Pytonballoon810/gdoor/hardware/boards/din/DESIGN.md

# GDoor DIN — design spec

A GDoor adapter for a 2-module DIN-rail enclosure (35 mm wide) with Ethernet,
audio and the bus interface on one board, the ESP32-S3 module soldered on.
Status: **layout routed and DRC-clean, schematic logic-checked (2026-10-18),
not yet built or tested.** The JLCPCB production files are in the repo (see
*Manufacturing*).

`esp32.kicad_sch` is the v4.1 bus and audio sheet (devkit removed);
`mcu_eth.kicad_sch` holds the new MCU, USB-C, power and Ethernet circuitry
(W5500 per WIZnet's WIZ850io reference). The file stem stays `esp32` because
the copied sheet stores its references under that project name.

Decisions (2026-10-16):

- Enclosure: 2 modules (35 mm), 3D printed. The PCB stands on edge, parallel
  to the side walls, so the connectors face the front window.
- MCU: ESP32-S3-WROOM-1-N8R2 module (8 MB flash, 2 MB quad PSRAM; PSRAM is
  needed for the VoIP audio stack), assembled by JLCPCB.
- Power: 5 V from USB-C or a screw terminal. No PoE, no power from the bus.
- Opening the door (bus TX) is mandatory and keeps its own pins; no feature
  may share them.

## Blocks

| Block | Based on | Notes |
|---|---|---|
| Bus interface (rectifier, RX filter and comparator, TX filter and driver, +5V_onoff switch) | v4.0 schematic | TX_EN switches the TX filter and driver supply (Q1/Q2), which keeps the TX stage off at boot. C10, R21 and C18 are DNP here but fitted on v4.0 (see *Open points*). |
| Bus voltage measurement | v4.0 (`BUS_DCVOLT`, R35/R73 100k/10k) | Divides by 11, so about 34 V reaches the ADC1 limit (v4.0 used 82k, ÷9.2). Closes issue #28 (bus connected/disconnected). |
| Audio codec ES8374 + bus coupling | v4.0 audio section | Own AMS1117 (U7, `+3.3V_ANA`). MONOOUT drives the bus through R32 and C21; the bus feeds MIC1P/MIC2P through C29/C31. Speaker outputs unused. |
| RX threshold | v4.0, fixed | The S3 has no DAC, so the fixed-threshold comparator U6A (`RX`, GPIO6) is used. The adjustable path (`RX_DAC`, R56) is removed; U6B is unused and sits latched high through R22/R27/R30/R31. |
| Ethernet | new: W5500 + HR911105A (magnetics and LEDs integrated) | 25 MHz crystal, WIZ850io reference circuit, PMODE all-capable. |
| MCU | new: ESP32-S3-WROOM-1-N8R2 | Native USB (flashing, console). SW101 = RESET (EN, 10k/1 µF), SW102 = BOOT (IO0, 10k). |
| USB-C | new: TYPE-C-31-M-12, 5.1 kΩ CC pull-downs, USBLC6-2SC6 ESD | Power and programming. |
| Power | AP2114H-3.3TRG1 (U103, LCSC C150716) for 3.3 V digital (S3 + W5500) | 5 V inputs OR-ed with SS14 Schottkys (D101 USB, D2 terminal). AP2114H: 1 A, 450 mV typ / 750 mV max dropout at 1 A, AMS1117 pinout (1 GND, 2/tab VOUT, 3 VIN). The AP2114**HA** has a different pinout and does not fit this footprint. 10 µF in (C104), 22 µF out (C106). |
| Status LEDs | new: two red 0603 LEDs, D103 (GPIO2, net `LED_GREEN_A`, 1 kΩ) and D104 (GPIO17, 1 kΩ) | D103 was green (C12624, Extended); JLC has no Basic green 0603, so it is the Basic red C2286 like D104, and R105 went from 100 Ω to 1 kΩ for the same ~1.3 mA. Issue #46. Plain LEDs instead of a WS2812, which needs more than 3.3 V logic when run from 5 V. |

## ESP32-S3 pin map

Avoided: GPIO0/3/45/46 (strapping; GPIO0 only for the BOOT button, GPIO3,
45 and 46 left open on their internal defaults), GPIO19/20 (USB), GPIO26–32
(flash/PSRAM), GPIO35–37 (kept free for octal-PSRAM module variants).

| Function | GPIO | Why there |
|---|---|---|
| Bus TX (LEDC PWM, 52 kHz) | 4 | mandatory, own pin |
| Bus TX enable | 5 | |
| Bus RX (comparator, digital) | 6 | |
| Bus RX analog | 7 | ADC1, usable with WiFi on |
| Bus DC voltage | 8 | ADC1 |
| Status LED D103 (red, net `LED_GREEN_A`) | 2 | |
| Status LED D104 (red) | 17 | |
| W5500 CS / MOSI / SCK / MISO | 10 / 11 / 12 / 13 | SPI2 IO_MUX pins, full speed |
| W5500 INT / RST | 14 / 21 | 4.7k pull-ups (also on CS) |
| I2S MCLK / BCLK / LRCK | 38 / 39 / 40 | S3 routes MCLK to any pin (the v4.0 GPIO0 problem is gone) |
| I2S DOUT (to codec DSDIN) / DIN (from codec ASDOUT) | 41 / 42 | |
| I2C SDA / SCL (codec control) | 47 / 48 | 2.4k pull-ups; codec address set by CE (R45 to GND) |
| Expansion header J103 (3V3, GND, TXD0, RXD0, IO15, IO16) | 43, 44, 15, 16 | serial console, sensors |

## Board and enclosure

- 4 layers, 1.6 mm, about 85 × 50 mm (height × depth in the housing), plus
  a 6.8 × 40.4 mm front tab (KiCad x 93.2–100, y 82.3–122.7). The tab sits
  in the 45 mm DIN front window, and its edge runs in a 0.3 mm groove in the
  window wall.
- Front: J102 (RJ45) and J101 (USB-C) stand on the tab, their faces 0.2 mm
  inside the window face (flush). The window has a body-sized RJ45 opening
  (16.6 × 13.9 mm), a stadium around the USB-C shell (9.4 × 3.7 mm) and two
  LED holes.
- Top edge: bus screw terminal J1 (2-pin, 3.5 mm) and 5 V screw terminal J4.
  Neither can take wires inside the enclosure (see *Open points*).
- RESET (SW101) and BOOT (SW102) are labelled on the silkscreen and on the
  lid, and pressed with a pin through the lid.
- The enclosure (printable base and lid, DIN clip) is in `enclosure/`; see
  its README. The bus connects through a pluggable 3.81 mm terminal on the
  top face, wired to J1's pads.
- Enclosure mirror fix (2026-10-22): up to then the enclosure was drawn
  around a mirror image of this board (`board_export.py` maps KiCad into the
  enclosure frame with a reflection), so the real board would not have
  fitted. `enclosure.scad` now mirrors every output about its mid-plane,
  which puts the lid on the other side; the real board fits, and the fit
  check is empty. See *Mirrored design frame* in the enclosure README.

## Layout

Stack-up and copper:

- The board's physical stackup is JLCPCB's JLC04161H-7628 (1.6 mm, 1 oz
  outer, 0.5 oz inner): 0.035 mm copper / 0.2104 mm 7628 prepreg (εr 4.4) /
  0.0152 mm / 1.065 mm core / 0.0152 mm / 0.2104 mm prepreg / 0.035 mm.
  Order the board with this stackup so KiCad's impedance numbers hold. A 2D
  field solve on it gives 65.7 Ω single-ended for a 0.2 mm track and
  98.8 Ω differential for the 0.2/0.15 mm USB and Ethernet RD pairs.
- F.Cu and B.Cu carry signals and a GND pour each (0.2 mm clearance, thermal
  reliefs, islands removed). In1.Cu is a GND plane, In2.Cu the +3.3V plane.
- GND stitching vias on a 3 mm grid tie the four layers together; each is
  placed only where it clears every other net.
- Antenna: the ESP32-S3-WROOM-1 footprint's own keepout covers F.Cu and
  B.Cu only. A rule area named "Antenna keepout (planes)" adds the same on
  In1.Cu and In2.Cu, so no plane runs under the antenna. The antenna sits at
  the board edge away from the RJ45.

Front-tab move (2026-10-17): J101 and J102 moved 8.45 mm forward (J102 also
0.8 mm down, to clear the top of the window), with their Ethernet parts
(R108, R117–R120, C121–C124) and USB parts (R103, D101, U102); R104 moved to
the old D101 corner. Tracks crossing the edge of the moved block kept their
geometry and got straight connectors along the move, so both halves of each
pair grew by the same amount: USB D+/D− skew is −4.20 mm (was −4.17), the
Ethernet pairs are unchanged. 17 stitching vias under the moved parts were
removed.

Rules (`esp32.kicad_pro`, `esp32.kicad_dru`, JLCPCB 4-layer):

- Vias 0.45 mm / 0.2 mm drill (JLCPCB standard, no extra cost on 4 layers);
  Default netclass track 0.2 mm; copper to edge 0.3 mm.
- The "PTH to Track" and "Pad to Track" rules apply to pads only; written
  for any item, they also caught vias and overrode the 0.254 mm via rule.
- Silkscreen text is 0.8 × 0.8 mm, 0.12 mm thick (the Nobble convention),
  placed clear of pads, other silk and the board edge. The "Minimum Text"
  rule was lowered from the JLC template's 1.0 / 0.15 to match. 39
  references in the densest 0402 groups (around the codec and the W5500)
  have no free spot and are hidden; they stay on F.Fab.

Parts removed from the copied v4.1 sheet:

- 2026-10-17: the microphone option parts C28, C30, R61–R66, R67 and R68,
  with their wiring; the codec speaker pins (U5 pins 11 and 14) are
  no-connects.
- 2026-10-18: the unfitted options R55 (+3.3V to `+3.3V_AUDIO` link), R56
  (`RX_DAC` link), R69–R72 (mic attenuation) and C62/C63 (alternative mic
  coupling), with their wiring and tracks.

Passives on the copied sheet are 0402 (C1, C12, C29, C31 stay 0603).

## Logic check (2026-10-18)

ERC has no errors; the 319 off-grid warnings come from the copied sheet.
Checked block
by block against the netlist:

- **Power:** both 5 V inputs are OR-ed by SS14 diodes (40 V). U103 and U7
  have their caps in place; the AP2114H has no enable pin.
- **USB:** CC1/CC2 have 5.1 kΩ pull-downs; ESD is on D+/D− and VBUS; D+/D−
  go to the module's USB pins.
- **ESP32-S3:** EN has 10k/1 µF and IO0 a 10k pull-up. IO3/45/46 are open,
  so the defaults hold: 3.3 V flash and normal boot.
- **W5500:** RSVD pins are tied to GND, PMODE pins high, EXRES 12.4k 1 %
  (R108 10k + R123 2.4k in series, see *Manufacturing*), TOCAP 4.7 µF,
  1V2O 10 nF. The 25 MHz crystal (C9006, CL 12 pF) has 15 pF caps and 1 MΩ
  across it (see *Simulation*). Analog supply goes through FB101. TX has 49.9 Ω to AVDD, RX is
  terminated 2 × 49.9 Ω to RX_CM (10 nF), and the shield goes through
  1 nF / 2 kV.
- **Bus:** RX is the v4.0 band-pass into U6A. TX is the band-pass U3 into
  the line driver U1, AC-coupled by C1 (47 nF 50 V).
- **Codec:** each supply has its own 33 Ω + 10 µF/100 nF. I2C has 100 Ω/22 pF
  in series and I2S 33 Ω/22 pF.

Found and fixed: the BOOT/RESET labels on the silkscreen (2026-10-17) and on
the enclosure lid were swapped. SW101 is wired to EN (RESET), SW102 to IO0
(BOOT).

## Simulation (2026-10-21)

`spice/` has an ngspice model of the bus side (bridge, RX and TX band-pass,
comparator, `+5V_onoff` switch, codec coupling). It runs on KiCad's bundled
`ngspice.dll`; numbers, assumptions and plots are in `spice/README.md`.

- **Fixed:** with R3/R4 = 100k the RX band-pass oscillated (see
  *Manufacturing*). They are back at 82k, as on v4.0.
- RX (82k) needs about 0.6 Vpp of 60 kHz carrier, or 0.4 Vpp at 52 kHz, on
  the bus terminals. TX puts 0.8–2.0 Vpp on them, depending on the bus
  impedance (assumed 30–300 Ω; not measured).
- Open risks, not confirmed on hardware: a driving codec MONOOUT shorts the
  RX signal through R32/C21. During TX, 16–31 mA of carrier flows into
  MONOOUT's ESD diodes. Plugging into a live bus pushes about 250 µC
  through MONOOUT into the codec supply, which U7 cannot sink (`+3.3V_ANA`
  rises to about 5 V in the model). The comparator rests only about 15 mV
  above its threshold.
- Ethernet (`spice/eth_sim.py`): return loss passes the 802.3 limit on both
  pairs with about 3.5 dB margin. The magjack is modelled from typical
  figures, so results above 30 MHz depend on that model. About 40 mA of TX
  current gives the nominal 1.0 V MLT-3 level. FB101 has no resonance
  problem. C121/C122 put the RX low corner at 220 kHz, as in WIZnet's
  reference.
- **Crystal load.** Y101 is C9006 (CL 12 pF, ±10 ppm, ±20 ppm over
  temperature, JLC Basic) since 2026-10-22, with C108/C109 at 15 pF (C1548,
  Basic). The model puts the pull at −5.5…+18.5 ppm for 3–5 pF stray, so the
  worst case with tolerance and temperature is about +48.5 ppm, inside
  802.3u's ±50 ppm. Before: C164045 (CL 20 pF, ±50 ppm over temperature,
  Extended); its 18 pF caps gave only 12–14 pF (+35…+55 ppm fast), and the
  33 pF fix of 2026-10-21 left no margin because of the ±50 ppm rating.

## Manufacturing

JLCPCB files live in `production/gdoor_din/` (gerbers, drill, BOM, CPL,
IPC netlist, iBOMs), generated by `jlcfab.py`:

```
"C:/Program Files/KiCad/10.0/bin/python.exe" jlcfab.py production/gdoor_din
```

It runs bennymeg's Fabrication Toolkit CLI (`-nI -nB -e -t -f`) on a copy of
the board in a temp directory and never writes the project files. `-f`
refills every zone before plotting.

- **Stale fill (fixed 2026-10-18):** the C10/R21 and C29/C31 changes were
  saved without a zone refill. Gerbers made from that fill had the GND pour
  over C10, R21 and C29 pads on F.Cu. The TX-node via at (129.0, 65.0) sat in
  GND and +3.3V. The GND vias at (128.3, 63.55) and (132.65, 64.3) sat in
  the In2 +3.3V plane. The board is now refilled and saved, and `-f` keeps a
  stale fill out of future exports.

On the copy, before the toolkit runs:

- **Rotation:** every part gets an `FT Rotation Offset`. `ROT_OVERRIDE`
  parts (Q1, Q2, U2, U3, D1, U102, J1) get a fixed final offset. Parts with
  the board's own `JlcRotOffset` / `JLCPCB Rotation Offset` (J4, U1, U5,
  U6, U7) keep exactly that offset. Every other part gets the toolkit's
  footprint-database correction. The overrides (2026-10-18) come from
  fitting JLC's EasyEDA footprint of each LCSC part onto the board's pads:
  `Library:SOT-23` and `Library:SOT-23-5` are drawn 180° from KiCad's
  standard footprints, so the database turned Q1/Q2/U2/U3 upside down;
  C2687116's EasyEDA SOT-23-6 is drawn turned 90°; J1's `JlcRotOffset`
  (-180) put its pads crosswise and is ignored.
- **Position:** U101 (ESP32 module, 3.63 mm: JLC's origin is the module
  centre), U7 (0.18 mm) and U103 (0.05 mm) get `FT Position Offset`s from
  the same fit.
- **J101 position:** J101 gets `FT Position Offset` `0,1.39`. KiCad's
  footprint origin sits 2.60 mm from the USB-C peg holes, JLC's model
  origin 1.206 mm. Aligned on the holes, JLC's point is 1.39 mm further
  +X on this board, where J101 sits at -90°. The CPL point is therefore
  97.09 / -108.0, not 95.70.
- **Hand-soldered parts left out:** `HAND_SOLDERED` parts are marked DNP,
  so they drop out of BOM and CPL like the DNP parts. This is the
  recommended, cheaper order; `hand_soldered.csv` lists those parts with
  C18 (quantities per board). A second pass keeps them in and writes
  `bom-full.csv` / `positions-full.csv` for a full PCBA order (Standard
  PCBA, C18 still by hand). J103 (expansion header) is a plain pin header
  (C37208). U101 (ESP32-S3-WROOM-1-N8R2, C2913204) cannot
  be placed in JLC's Economic PCBA. Its castellated pins take an iron; the
  centre GND pad (pad 41, split into sub-pads, one 0.3 mm via) needs hot air
  or a hot plate. The module is also grounded through pins 1 and 40. J1
  (C695629), J102 (C69427, HY911105AE), U103 (C150716), U102 (C2687116), U2/U3 (C7972)
  and C19/C20/C59 (C23742) are Extended parts that are easy to solder by
  iron; leaving them off saves JLC's $3 loading fee per part type. Order
  all of them from LCSC separately. Y101 stays with JLC: its pads are under
  the crystal.

After the toolkit:

- **BOM columns:** they are rewritten to JLC's template: `Comment,
  Designator, Footprint, LCSC Part #`. The toolkit's `Value`/`Quantity`
  columns made the PCBA quote fail ("fee item calculate failed").
- **BOM lines merged:** lines with the same LCSC part are merged, so a
  value spelled two ways ("4k7"/"4.7k") does not make JLC report two lines
  matched to one part.
- **Self-check:** the script checks that BOM and CPL list the same
  designators, that every BOM line has an LCSC number and no LCSC part is
  on two lines, and the CPL points and rotations of the corrected parts.
  It exits non-zero on a problem.

Extended-part fees (2026-10-18): none of these values is a JLC Basic 0402
part, so they were moved to fee-free parts:

- 18k (C25762), 2.4k (C25882) and 6.8 nF (C1542): same values,
  Preferred Extended parts (no loading fee in Economic PCBA).
- 82k → 100k Basic (C25741) for R18/R19 and R35. R18/R19 set the 2.5 V
  midpoint of the TX band-pass and are also its ground leg: with 100k its peak
  moves from 56 to 51 kHz, onto the 52 kHz TX carrier (+2.8 dB). R35
  changes the bus-voltage divider (see the table above).
- **R3/R4 stay 82k.** They were 100k from 7ce317d until 2026-10-21. They are
  the ground leg of the RX Sallen-Key band-pass (gain 1.94), and with 100k it
  oscillates on its own at about 49 kHz. It is stable below about 90k. See
  *Simulation*. JLC has no fee-free 82k in 0402, so they are 0603 since
  2026-10-22 (see below).
- R112/R113/R117/R118, 3.3 Ω → 0 Ω (C17168): series resistors between the
  W5500 TX/RX pins and the 49.9 Ω terminations, which sit on the magnetics
  side. The footprints stay, so 3.3 Ω can go back if EMI needs it.
- D103 green → red (C2286), R105 100 Ω → 1 kΩ (C11702).

Extended-part fees (2026-10-22): four more types made fee-free, values kept.
That saves $12 of the $24 that the eight charged types cost.

- R3/R4 82k: 0402 C2909388 → **0603 C23254** (Basic).
- R1/R20 130k: 0402 C2909318 → **0603 C22795** (Preferred Extended).
  The 0603 pads pushed two tracks: `Net-(J1-Pin_2)` between R3 and R5 now
  runs at y = 68.72 instead of 68.6, and the `Net-(C8-Pad2)` diagonal next to
  R20 moved 0.35 mm towards the `Net-(Q2-B)` track. The +3.3V via at R3 pad 2
  and the GND via at R4 pad 1 now sit partly under their (same-net) pads, as
  the C10-Pad2 via at R20 already did.
- R108 12.4k 1% (C2929935) → **R108 10k (C25744, Basic) + R123 2.4k
  (C25882, Preferred) in series**, 12.4k exactly; both 1 %. The node between
  them is `ETH_EXRES_LO`. R123 sits below R108; the GND via that was next to
  R108 pad 2 moved to R123 pad 2. R123's silkscreen reference is hidden (no
  free spot; it is on F.Fab). A single 12k would raise the TX amplitude by
  3.3 % of 802.3's ±5 %.
- Y101 C164045 → **C9006** (Basic), same 3225-4P footprint; C108/C109
  33 pF → **15 pF** (C1548) for its CL of 12 pF. See *Simulation*.
- Still Extended at JLC: U1 (no fee-free op amp has 20 V/µs and ±60 mA),
  U5, U104 and J101 (no fee-free USB-C exists).

The iBOMs: `ibom.html` comes from the InteractiveHtmlBom plugin (with tracks
and nets), `ibom-partdb.html` from `partdb_ibom.py` (Part-DB storage and JLC
cost; `--offline` reuses `jlc-prices.json`).

Other notes:

- **No popups:** KiCad's python pops a modal wx dialog for every assert and
  log message. The script disables both, and stubs
  `pcbnew.ActionPlugin.register`, before importing anything. Otherwise
  the toolkit asserts ("PgmOrNull()" failed in register_action).
- **LCSC numbers** come from the `LCSC` field, or from `MPN` on the copied
  sheet.
- **Single-sided assembly:** every B.Cu part is DNP. Left on B.Cu: C18
  (hand-soldered, see *Open points*) and the ESD logo S1.
- **Check rotations** in JLCPCB's placement preview anyway. D104 and J101
  look wrong to the pad fit and are right: JLC's LED numbers the cathode
  pad 2 (matched by cathode, 0° is correct), and J101 is aligned on its
  peg holes, not on its signal pads.

## Firmware impact

- MQTT firmware: needs an S3 build environment and a third pin map (in
  addition to v3.x and v4.0); Ethernet via the existing W5500 support with the
  new pins; the RX threshold via LEDC PWM instead of `dacWrite`.
- Audio: the working VoIP firmware (ESP-ADF) is the maintainer's private code;
  this board only provides the hardware for it.

## Open points

Decisions:

- **C10, R21, C18** (done 2026-10-18): fitted on the upstream
  `hardware/boards/esp32-mini` board, so they are fitted here too.
  - C18 (100 pF) filters the TX driver input (U1 +, with R11 10k).
  - C10 (1 nF) and R21 (4k7) load the TX node behind R34; R21 also pulls TX
    low while the pin floats.
  - C10 and R21 are on F.Cu and fitted by JLC, at (131.25, 64.3) and
    (128.9, 64.3). A via at (129.0, 65.0) joins them to the old B.Cu TX-node
    track, and GND vias at (128.3, 63.55) and (132.65, 64.3) ground them.
  - C18 stays on B.Cu, routed but DNP: **hand-solder it** (100 pF 0402,
    C1546). There is no free F.Cu spot near U1 or R11, because the strip
    above U1 is crossed by the C1-Pad1 and +5V_onoff diagonals and Q2 and
    R14/R15/R16/R24 close in on the other sides.
- **C29, C31** (done 2026-10-18): they sit on the bus DC through R74, so
  they now have a 50 V rating (the bus runs up to about 30 V).
  - C29: 10 µF 50 V 1206 (C13585, like C21), at (120.6, 106.3).
  - C31: 10 µF 50 V 0805 (C440198, Murata GRM21BR61H106KE43L), at (129.357,
    100.5); a 1206 did not fit there. Its pad-1 route to R40 now runs down
    the right side of the part at x 130.385.
- **0 Ω links:** R34, R36, R57, R58, R59, R60 and R74 are fitted 0 Ω links
  left over from upstream options. They could become plain copper (7 fewer
  placements), but each one would need a schematic and routing change.
- **J4 and D2:** the 5 V terminal cannot take wires in the enclosure (its
  entries face the top wall), so the second 5 V input is only usable with
  wires soldered to J4's pads. Keep it, or drop J4 and D2.
- **Unused parts:** U6B with its four resistors, and the codec's MICBIAS caps
  C22/C35, are unused on this board. They are kept so the unused inputs stay
  defined.
- **Status LEDs** (done 2026-10-18): both are red now, each with 1 kΩ
  (about 1.3 mA), so they are equally bright.

To do in KiCad:

- **Tidy:** the front-tab connectors are long straight runs across the
  strip the move emptied (x 113–122, y 98–113). That strip also has room for
  new stitching vias.

To check on the first build:

- U103 is a JLC extended part ($3 fee); check its rotation in the placement
  preview.
- Front window: the RJ45 opening, the USB-C stadium and the tab groove
  (1.1 mm of wall left) need checking on the first print.
- J1 should be DNP: the enclosure wires the bus plug straight to its pads,
  but it is in the JLC BOM as C695629.
- J103 (expansion header, C37208) is hand-soldered in the recommended order.
- Several decoupling caps sit further from their pins than ideal (C116,
  C57, C59, C61, C29 are 5–12 mm away), and some codec/W5500 routes meander.
