Pytonballoon810/gdoor/hardware/boards/din/production/gdoor_din/bom-full.csv

Comment | Designator | Footprint | LCSC Part #
47n | C1 | 0603 | C1622
1n | C10 | 0402 | C1523
10u | C101, C104, C105, C112, C116 | 0603 | C19702
100n | C22, C24, C26, C32, C33, C34, C102, C107, C114, C115, C117, C118, C119 | 0402 | C1525
1u | C103, C113 | 0402 | C52923
22u | C106 | 0805 | C45783
15p | C108, C109 | 0402 | C1548
100n | C3, C5, C6, C7, C11, C13, C15, C16, C17, C36, C38, C40, C42, C46, C51, C53, C55 | 0402 | C307331
4.7u | C110 | 0603 | C19666
10n | C111, C123 | 0402 | C15195
10u | C12 | 0603 | C96446
22n | C120 | 0402 | C1532
6.8n | C121, C122 | 0402 | C1542
1n 2kV | C124 | 1206 | C9196
10u | C14, C23, C25, C27, C35, C37, C39, C41, C43, C47, C52, C54, C56 | 0402 | C15525
100u | C19, C20, C59 | 1210 | C23742
100p | C2, C4, C8, C9 | 0402 | C1546
10u | C21, C29, C57 | 1206 | C13585
10u | C31 | 0805 | C440198
22p | C44, C45, C48, C49, C50, C61 | 0402 | C1555
MB10S | D1 | SOIC-4_4.55x3.7mm_P2.54mm | C2488
SS14 | D2, D101 | D_SMA | C2480
red | D103, D104 | 0603 | C2286
120R@100MHz | FB101 | 0603 | C14709
PlugIn_Terminal_Screw | J1, J4 | anschlussklemme2x1_3_5 | C695629
USB-C | J101 | USB_C_Receptacle_HRO_TYPE-C-31-M-12 | C165948
HY911105AE | J102 | RJ45_Hanrun_HR911105A_Horizontal | C69427
EXP | J103 | PinHeader_1x06_P2.54mm_Vertical | C37208
MMBT5401 | Q1 | SOT-23 | C8326
MMBT2222A | Q2 | SOT-23 | C8512
130k | R1, R20 | 0603 | C22795
18k | R6, R10, R15, R22, R27, R33 | 0402 | C25762
10k | R8, R11, R13, R23, R24, R29, R31, R45, R73, R101, R102, R108 | 0402 | C25744
5.1k | R5, R7, R16, R17, R103, R104 | 0402 | C25905
1k | R14, R37, R38, R39, R40, R105, R106 | 0402 | C11702
1M | R107 | 0402 | C26083
4.7k | R21, R26, R109, R110, R111 | 0402 | C25900
0 | R34, R36, R57, R58, R59, R60, R74, R112, R113, R117, R118 | 0402 | C17168
49.9 1% | R114, R115, R119, R120 | 0402 | C25120
10 | R116 | 0402 | C25077
2k4 | R12, R25, R46, R47, R123 | 0402 | C25882
330 | R121, R122 | 0402 | C25104
100k | R18, R19, R35 | 0402 | C25741
22k | R2 | 0402 | C25768
47k | R9, R28, R30 | 0402 | C25792
82k | R3, R4 | 0603 | C23254
22 | R32 | 0402 | C25092
33 | R41, R42, R43, R44, R50, R51, R52, R53, R54 | 0402 | C25105
100 | R48, R49 | 0402 | C25076
TL3342 | SW101, SW102 | SW_SPST_TL3342 | C318884
TLV9351 | U1 | SOT-353_SC-70-5 | C4367425
ESP32-S3-WROOM-1-N8R2 | U101 | ESP32-S3-WROOM-1 | C2913204
USBLC6-2SC6 | U102 | SOT-23-6 | C2687116
AP2114H-3.3TRG1 | U103 | SOT-223-3_TabPin2 | C150716
W5500 | U104 | LQFP-48_7x7mm_P0.5mm | C32843
LMV321 | U2, U3 | SOT-23-5 | C7972
ES8374 | U5 | QFN-28-1EP_4x4mm_P0.45mm_EP2.4x2.4mm | C365738
LM393 | U6 | SOIC-8_3.9x4.9mm_P1.27mm | C7955
AMS1117-3.3 | U7 | SOT-223-3_TabPin2 | C6186
25MHz | Y101 | Crystal_SMD_3225-4Pin_3.2x2.5mm | C9006
