Pytonballoon810/gdoor/hardware/boards/din/production/gdoor_din/bom-partdb.csv

Comment | Designator | Footprint | LCSC Part # | Qty | JLC Type | JLC Cost (5 boards, USD) | Extended Fee | Hand Solder | Storage Location | Stock | Part-DB Part | Part-DB ID | Match | Note | Suggestion | Suggestion Location
47n | C1 | 0603 | C1622 | 1 | base | 0.12 | 0.00 | easy |  |  |  |  | none |  | 100n CL10B104KB8NNNC (0603): same package, 100n instead of 47n (x2.1) -- changes the circuit | Cryo2 > Cryo2.4
1n | C10 | 0402 | C1523 | 1 | base | 0.08 | 0.00 | fiddly | Cryo2 > Cryo2.2 | 200 | CC0402KRX7R9BB102 | 34 | value+footprint
10u | C101, C104, C105, C112, C116 | 0603 | C19702 | 5 | base | 0.95 | 0.00 | easy |  |  |  |  | none | value matches CL21A106KAYNNNE (0805) but the footprint does not | 10u CL05A106MQ5NUNC (0402): same value, 0402 instead of 0603 | Cryo2 > Cryo2.22
100n | C102, C107, C114, C115, C117, C118, C119, C22, C24, C26, C32, C33, C34 | 0402 | C1525 | 13 | base | 0.38 | 0.00 | fiddly | Cryo2 > Cryo2.17 | unknown | CC0402KRX7R7BB104 | 169 | value+footprint
1u | C103, C113 | 0402 | C52923 | 2 | base | 0.14 | 0.00 | fiddly | Cryo2 > Cryo2.23 | unknown | CL05A105KP5NNNC | 175 | value+footprint
22u | C106 | 0805 | C45783 | 1 | base | 1.74 | 0.00 | easy | Cryo2 > Cryo2.3 | 20 | CL21A226MOQNNNE | 35 | value+footprint
18p | C108, C109 | 0402 | C1549 | 2 | base | 0.05 | 0.00 | fiddly |  |  |  |  | none |  | 30p CC0402FRNPO9BN300 (0402): same package, 30p instead of 18p (x1.7) -- changes the circuit | Cryo2 > Cryo2.20
100n | C11, C13, C15, C16, C17, C3, C36, C38, C40, C42, C46, C5, C51, C53, C55, C6, C7 | 0402 | C307331 | 17 | base | 0.94 | 0.00 | fiddly | Cryo2 > Cryo2.17 | unknown | CC0402KRX7R7BB104 | 169 | value+footprint
4.7u | C110 | 0603 | C19666 | 1 | base | 0.44 | 0.00 | easy |  |  |  |  | none | value matches CL21A475KAQNNNE (0805) but the footprint does not | 4.7u CL05A475KP5NRNC (0402): same value, 0402 instead of 0603 | Cryo2 > Cryo2.19
10n | C111, C123 | 0402 | C15195 | 2 | base | 0.08 | 0.00 | fiddly | Cryo2 > Cryo2.1 | 200 | CC0402KRX7R9BB103 | 33 | value+footprint
10u | C12 | 0603 | C96446 | 1 | base | 0.97 | 0.00 | easy |  |  |  |  | none | value matches CL21A106KAYNNNE (0805) but the footprint does not | 10u CL05A106MQ5NUNC (0402): same value, 0402 instead of 0603 | Cryo2 > Cryo2.22
22n | C120 | 0402 | C1532 | 1 | base | 0.18 | 0.00 | fiddly |  |  |  |  | none | value matches CC0805KRX7R9BB223 (0805) but the footprint does not | 10n CC0402KRX7R9BB103 (0402): same package, 10n instead of 22n (x2.2) -- changes the circuit | Cryo2 > Cryo2.1
6.8n | C121, C122 | 0402 | C93654 | 2 | expand | 0.04 | 3.00 | fiddly |  |  |  |  | none |  | 10n CC0402KRX7R9BB103 (0402): same package, 10n instead of 6.8n (x1.5) -- changes the circuit | Cryo2 > Cryo2.1
1n 2kV | C124 | 1206 | C9196 | 1 | base | 0.34 | 0.00 | easy |  |  |  |  | none
10u | C14, C23, C25, C27, C35, C37, C39, C41, C43, C47, C52, C54, C56 | 0402 | C15525 | 13 | base | 1.93 | 0.00 | fiddly | Cryo2 > Cryo2.22 | unknown | CL05A106MQ5NUNC | 174 | lcsc
100u | C19, C20, C59 | 1210 | C23742 | 3 | expand | 4.22 | 3.00 | easy |  |  |  |  | none | value matches CL31A107MQHNNNE (1206) but the footprint does not | 100u CL31A107MQHNNNE (1206): same value, 1206 instead of 1210 | Cryo2 > Cryo2.5
100p | C2, C4, C8, C9 | 0402 | C1546 | 4 | base | 0.10 | 0.00 | fiddly |  |  |  |  | none
10u | C21, C29, C57 | 1206 | C13585 | 3 | base | 4.85 | 0.00 | easy |  |  |  |  | none | value matches CL21A106KAYNNNE (0805) but the footprint does not | 10u CL21A106KAYNNNE (0805): same value, 0805 instead of 1206 | Cryo2 > Cryo2.8
10u | C31 | 0805 | C440198 | 1 | base | 1.45 | 0.00 | easy | Cryo2 > Cryo2.9 | 25 | GRM21BR61H106KE43L | 118 | lcsc
22p | C44, C45, C48, C49, C50, C61 | 0402 | C1555 | 6 | base | 0.10 | 0.00 | fiddly |  |  |  |  | none |  | 30p CC0402FRNPO9BN300 (0402): same package, 30p instead of 22p (x1.4) -- changes the circuit | Cryo2 > Cryo2.20
MB10S | D1 | SOIC-4_4.55x3.7mm_P2.54mm | C2488 | 1 | base | 0.30 | 0.00 | easy |  |  |  |  | none
SS14 | D101, D2 | D_SMA | C2480 | 2 | base | 0.38 | 0.00 | easy |  |  |  |  | none
green | D103 | 0603 | C12624 | 1 | expand | 0.24 | 3.00 | easy |  |  |  |  | none | value matches SZYY0402G (0402) but the footprint does not | green SZYY0402G (0402): same colour, 0402 instead of 0603 | Cryo5 > Cryo5.11
red | D104 | 0603 | C2286 | 1 | base | 0.15 | 0.00 | easy |  |  |  |  | none
120R@100MHz | FB101 | 0603 | C14709 | 1 | base | 0.30 | 0.00 | easy |  |  |  |  | none | value matches 0805W8F1200T5E (0805) but the footprint does not | 120R 0805W8F1200T5E (0805): same value, 0805 instead of 0603 | Cryo6 > Cryo6.3
PlugIn_Terminal_Screw | J1 | anschlussklemme2x1_3_5 | C695629 | 1 | expand | 0.66 | 3.00 | easy |  |  |  |  | none
USB-C | J101 | USB_C_Receptacle_HRO_TYPE-C-31-M-12 | C165948 | 1 | expand | 0.93 | 3.00 | fiddly | Großes Kallax > Modulares Kleinstbauteil-Segregationsmagazin 4 | 18 | TYPE-C-31-M-12 | 74 | lcsc
HY911105AE | J102 | RJ45_Hanrun_HR911105A_Horizontal | C69427 | 1 | expand | 15.00 | 3.00 | easy |  |  |  |  | none
MMBT5401 | Q1 | SOT-23 | C8326 | 1 | base | 0.15 | 0.00 | easy |  |  |  |  | none
MMBT2222A | Q2 | SOT-23 | C8512 | 1 | base | 0.19 | 0.00 | easy |  |  |  |  | none
130k | R1, R20 | 0402 | C2909318 | 2 | expand | 0.02 | 3.00 | fiddly |  |  |  |  | none |  | 150k 0402WGF1503TCE (0402): same package, 150k instead of 130k (x1.2) -- changes the circuit | Cryo1 > Cryo1.17
18k | R10, R15, R22, R27, R33, R6 | 0402 | C2909327 | 6 | expand | 0.06 | 3.00 | fiddly |  |  |  |  | none |  | 20k 0402WGF2002TCE (0402): same package, 20k instead of 18k (x1.1) -- changes the circuit | Cryo1 > Cryo1.11
10k | R101, R102, R11, R13, R23, R24, R29, R31, R45, R73, R8 | 0402 | C25744 | 11 | base | 0.10 | 0.00 | fiddly | Cryo1 > Cryo1.4 [RC0402FR-0710KL]; Cryo1 > Cryo1.12 [WR04X1002FTL] | 100; unknown | RC0402FR-0710KL; WR04X1002FTL | 8; 93 | value+footprint, 2 candidates
5.1k | R103, R104, R16, R17, R5, R7 | 0402 | C25905 | 6 | base | 0.09 | 0.00 | fiddly | Cryo1 > Cryo1.10 | unknown | 0402WGF5101TCE | 97 | lcsc
100 | R105, R48, R49 | 0402 | C25076 | 3 | base | 0.03 | 0.00 | fiddly |  |  |  |  | none | value matches AR03BTCX1000 (0603) but the footprint does not | 100 AR03BTCX1000 (0603): same value, 0603 instead of 0402 | Cryo4 > Cryo4.6
1k | R106, R14, R37, R38, R39, R40 | 0402 | C11702 | 6 | base | 0.05 | 0.00 | fiddly | Cryo1 > Cryo1.6 | 200 | 0402WGF1001TCE | 87 | lcsc
1M | R107 | 0402 | C26083 | 1 | base | 0.05 | 0.00 | fiddly | Cryo1 > Cryo1.15 | 200 | 0402WGF1004TCE | 4 | lcsc
12.4k 1% | R108 | 0402 | C2929935 | 1 | expand | 0.03 | 3.00 | fiddly |  |  |  |  | none |  | 15k RC0402FR-0715KL (0402): same package, 15k instead of 12.4k (x1.2) -- changes the circuit | Cryo1 > Cryo1.2
4.7k | R109, R110, R111, R26 | 0402 | C25900 | 4 | base | 0.06 | 0.00 | fiddly | Cryo1 > Cryo1.19 | unknown | 0402WGF4701TCE | 88 | lcsc
3.3 | R112, R113, R117, R118 | 0402 | C2933094 | 4 | expand | 0.06 | 3.00 | fiddly |  |  |  |  | none |  | 2.49 RC0402FR-072R49L (0402): same package, 2.49 instead of 3.3 (x1.3) -- changes the circuit | Cryo1 > Cryo1.23
49.9 1% | R114, R115, R119, R120 | 0402 | C25120 | 4 | base | 0.07 | 0.00 | fiddly |  |  |  |  | none |  | 27.4 ARG02FTC27R4 (0402): same package, 27.4 instead of 49.9 (x1.8) -- changes the circuit | Cryo1 > Cryo1.9
10 | R116 | 0402 | C25077 | 1 | base | 0.03 | 0.00 | fiddly |  |  |  |  | none
2k4 | R12, R25, R46, R47 | 0402 | C144772 | 4 | expand | 0.12 | 3.00 | fiddly |  |  |  |  | none |  | 2.7k RTT022701FTH (0402): same package, 2.7k instead of 2k4 (x1.1) -- changes the circuit | Cryo1 > Cryo1.20
330 | R121, R122 | 0402 | C25104 | 2 | base | 0.02 | 0.00 | fiddly |  |  |  |  | none | value matches 25121WJ0331T4E (2512) but the footprint does not
82k | R18, R19, R3, R35, R4 | 0402 | C2909388 | 5 | expand | 0.05 | 3.00 | fiddly |  |  |  |  | none |  | 100k SCR0402F100K (0402): same package, 100k instead of 82k (x1.2) -- changes the circuit | Cryo1 > Cryo1.7
22k | R2 | 0402 | C25768 | 1 | base | 0.02 | 0.00 | fiddly | Cryo1 > Cryo1.21 | unknown | 0402WGJ0223TCE | 89 | value+footprint
4k7 | R21 | 0402 | C25900 | 1 | base | 0.04 | 0.00 | fiddly | Cryo1 > Cryo1.19 | unknown | 0402WGF4701TCE | 88 | lcsc
47k | R28, R30, R9 | 0402 | C25792 | 3 | base | 0.05 | 0.00 | fiddly |  |  |  |  | none |  | 50k RTT025002FTH (0402): same package, 50k instead of 47k (x1.1) -- changes the circuit | Cryo1 > Cryo1.3
22 | R32 | 0402 | C25092 | 1 | base | 0.03 | 0.00 | fiddly |  |  |  |  | none |  | 27 RC0402FR-0727RL (0402): same package, 27 instead of 22 (x1.2) -- changes the circuit
0 | R34, R36, R57, R58, R59, R60, R74 | 0402 | C17168 | 7 | base | 0.05 | 0.00 | fiddly | Cryo1 > Cryo1.22 | unknown | 0402WGF0000TCE | 91 | lcsc
33 | R41, R42, R43, R44, R50, R51, R52, R53, R54 | 0402 | C25105 | 9 | base | 0.06 | 0.00 | fiddly |  |  |  |  | none |  | 27.4 ARG02FTC27R4 (0402): same package, 27.4 instead of 33 (x1.2) -- changes the circuit | Cryo1 > Cryo1.9
TL3342 | SW101, SW102 | SW_SPST_TL3342 | C318884 | 2 | base | 0.37 | 0.00 | easy |  |  |  |  | none
TLV9351 | U1 | SOT-353_SC-70-5 | C4367425 | 1 | expand | 2.72 | 3.00 | fiddly |  |  |  |  | none
ESP32-S3-WROOM-1-N8R2 | U101 | ESP32-S3-WROOM-1 | C2913204 | 1 | expand | 23.26 | 3.00 | easy |  |  |  |  | none
USBLC6-2SC6 | U102 | SOT-23-6 | C2687116 | 1 | expand | 0.47 | 3.00 | easy |  |  |  |  | none
AP2114H-3.3TRG1 | U103 | SOT-223-3_TabPin2 | C150716 | 1 | expand | 1.62 | 3.00 | easy |  |  |  |  | none
W5500 | U104 | LQFP-48_7x7mm_P0.5mm | C32843 | 1 | expand | 14.11 | 3.00 | hard |  |  |  |  | none
LMV321 | U2, U3 | SOT-23-5 | C7972 | 2 | preferred | 1.73 | 0.00 | easy |  |  |  |  | none
ES8374 | U5 | QFN-28-1EP_4x4mm_P0.45mm_EP2.4x2.4mm | C365738 | 1 | expand | 4.60 | 3.00 | hard |  |  |  |  | none
LM393 | U6 | SOIC-8_3.9x4.9mm_P1.27mm | C7955 | 1 | base | 0.40 | 0.00 | easy |  |  |  |  | none
AMS1117-3.3 | U7 | SOT-223-3_TabPin2 | C6186 | 1 | base | 1.04 | 0.00 | easy | Cryo3 > Cryo3.18 | 5 | AMS1117-3.3 | 140 | lcsc
25MHz | Y101 | Crystal_SMD_3225-4Pin_3.2x2.5mm | C164045 | 1 | expand | 0.69 | 3.00 | easy |  |  |  |  | none
