Pytonballoon810/gdoor/hardware/boards/din/3dmodels/ES8374_QFN-28_4x4mm_P0.45mm.step

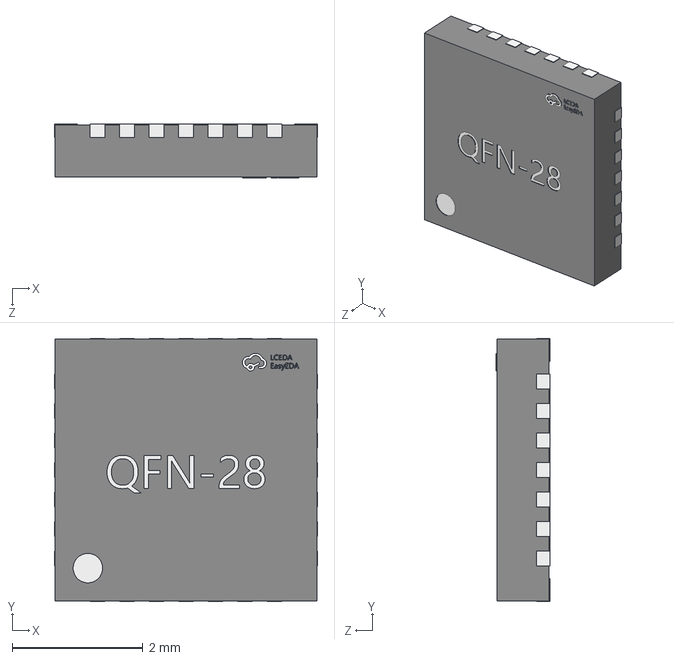
[picture p3: CAD file, 2026-10-18]
hardware/boards/din/3dmodels/ES8374_QFN-28_4x4mm_P0.45mm.step
4.02 x 4.02 x 0.82 mm
