Pytonballoon810/gdoor/hardware/boards/din/3dmodels/MB10S_MBS.step

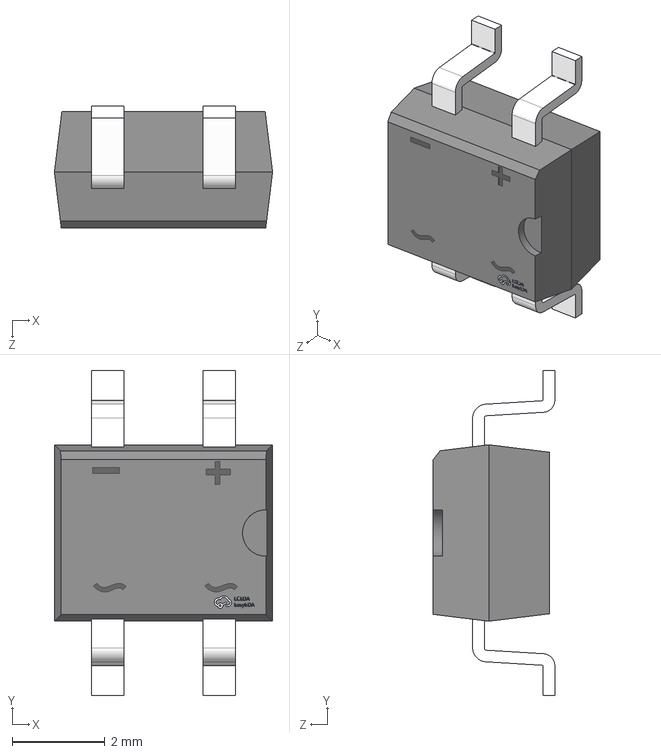
[picture p4: CAD file, 2026-10-18]
hardware/boards/din/3dmodels/MB10S_MBS.step
4.70 x 7.00 x 2.62 mm
