Pytonballoon810/gdoor/hardware/boards/din/enclosure/gdoor-din-lid-body.stl

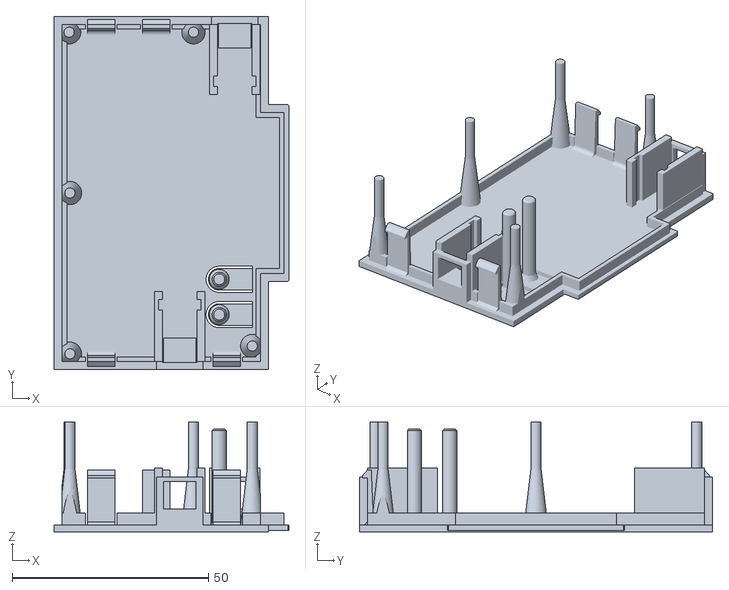
[picture p5: CAD file, 2026-10-24]
hardware/boards/din/enclosure/gdoor-din-lid-body.stl
59.8 x 90.0 x 28.0
