Pytonballoon810/gdoor/hardware/boards/esp32-mini/3dmodels/User Library-WJ127-5_0-2P.step

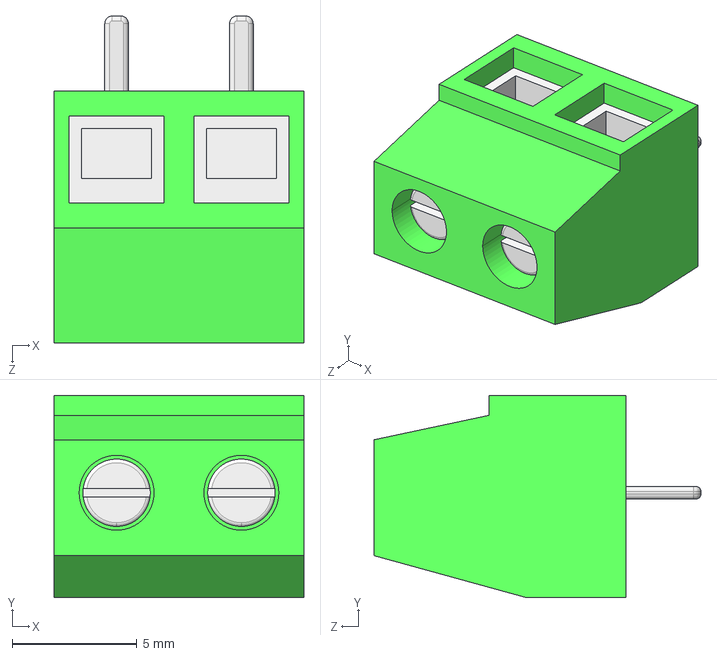
[picture p6: CAD file, 2026-10-18]
hardware/boards/esp32-mini/3dmodels/User Library-WJ127-5_0-2P.step
10.0 x 8.10 x 13.1 mm
