Pytonballoon810/gdoor/hardware/boards/din/3dmodels/USB_C_HRO_TYPE-C-31-M-12.step

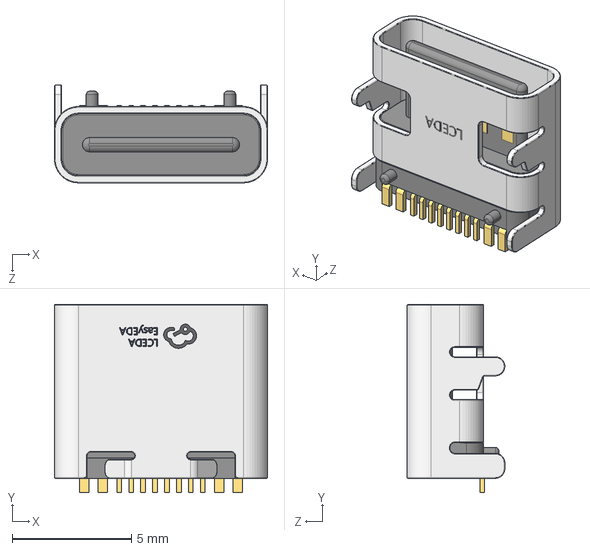
[picture p7: CAD file, 2026-10-18]
hardware/boards/din/3dmodels/USB_C_HRO_TYPE-C-31-M-12.step
8.94 x 7.90 x 4.10 mm
