Pytonballoon810/gdoor/hardware/boards/din/enclosure/gdoor-din-lid.step

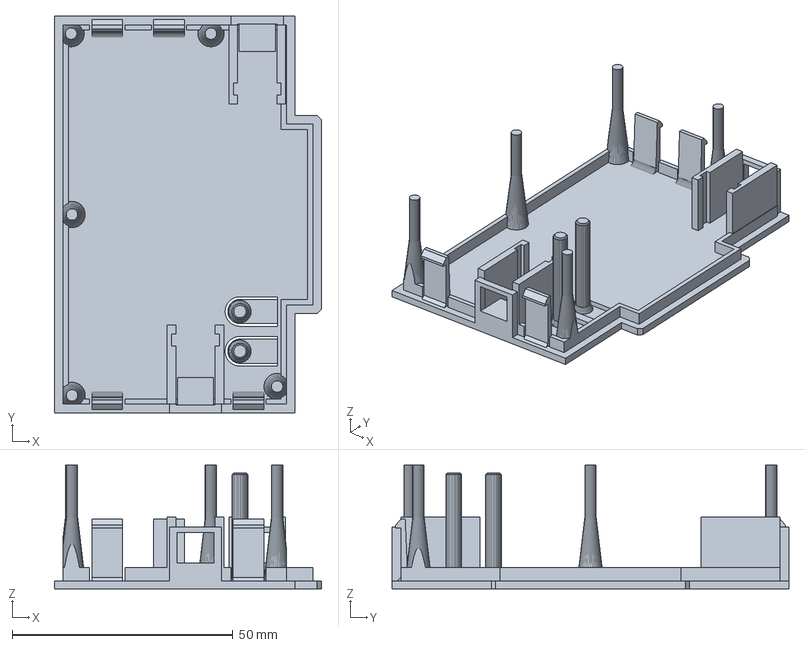
[picture p8: CAD file, 2026-10-24]
hardware/boards/din/enclosure/gdoor-din-lid.step
60.6 x 90.0 x 28.0 mm
