Pytonballoon810/gdoor/hardware/boards/esp32-mini/3dmodels/esp32-wemos-d1-mini.step

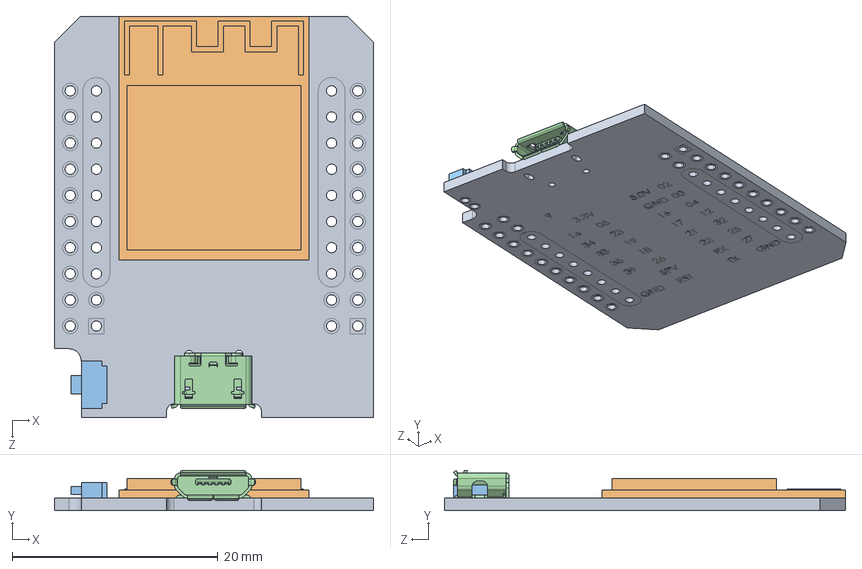
[picture p9: CAD file, 2026-10-18]
hardware/boards/esp32-mini/3dmodels/esp32-wemos-d1-mini.step
31.0 x 3.92 x 39.0 mm
