Pytonballoon810/gdoor/hardware/boards/din/3dmodels/RJ45_Hanrun_HR911105A.step

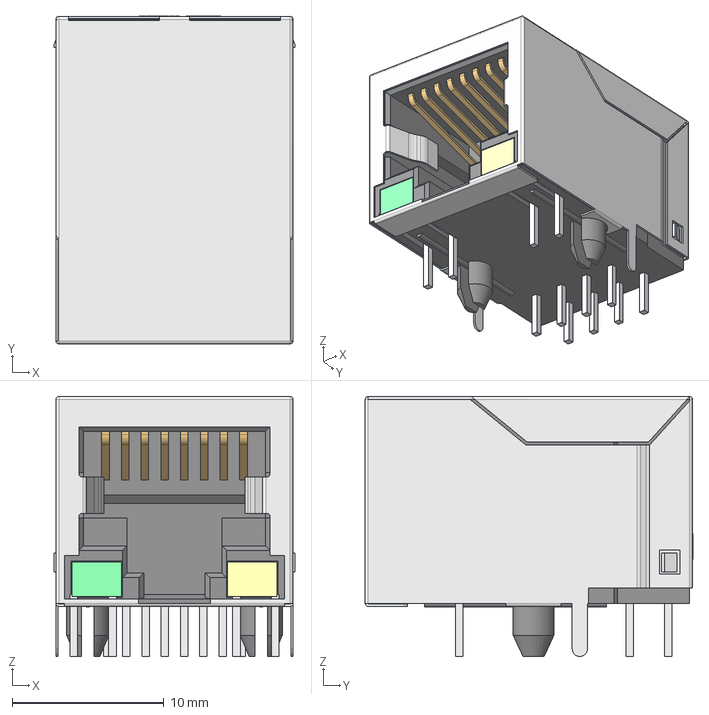
[picture p10: CAD file, 2026-10-18]
hardware/boards/din/3dmodels/RJ45_Hanrun_HR911105A.step
15.9 x 21.6 x 17.1 mm
