Pytonballoon810/gdoor/hardware/boards/din/enclosure/gdoor-din.3mf

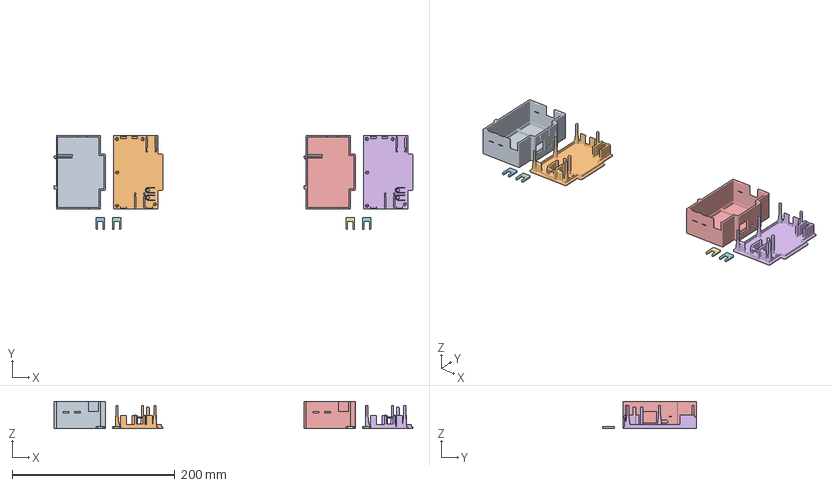
[picture p11: CAD file, 2026-10-24]
hardware/boards/din/enclosure/gdoor-din.3mf
441.2 x 115.0 x 33.2 mm
gdoor-din-base
gdoor-din-lid
gdoor-din-keeper-1 x 2
gdoor-din-keeper-2 x 2
gdoor-din-base-colour
gdoor-din-lid-colour
