Pytonballoon810/gdoor/hardware/boards/din/enclosure/gdoor-din-enclosure.step

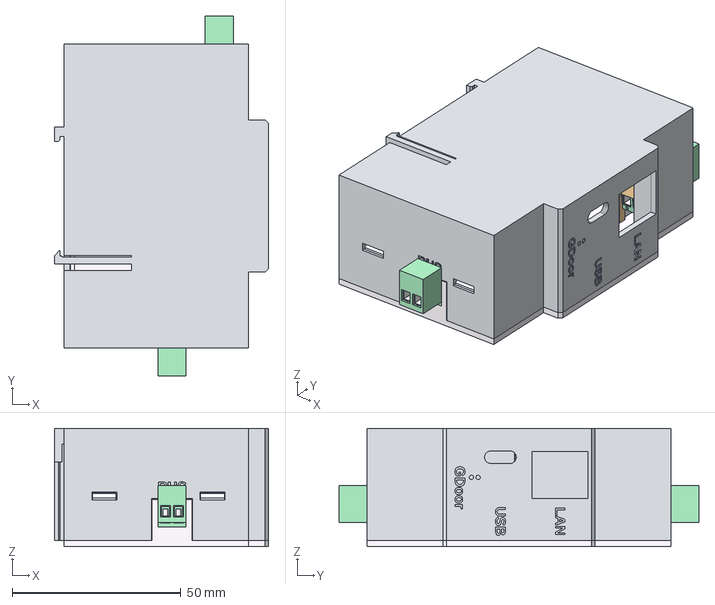
[picture p12: CAD file, 2026-10-24]
hardware/boards/din/enclosure/gdoor-din-enclosure.step
63.4 x 106.6 x 35.0 mm
