Pytonballoon810/gdoor/hardware/boards/esp32-mini/3dmodels/ESP32-S3-DEVKITC-1-N8R2.step

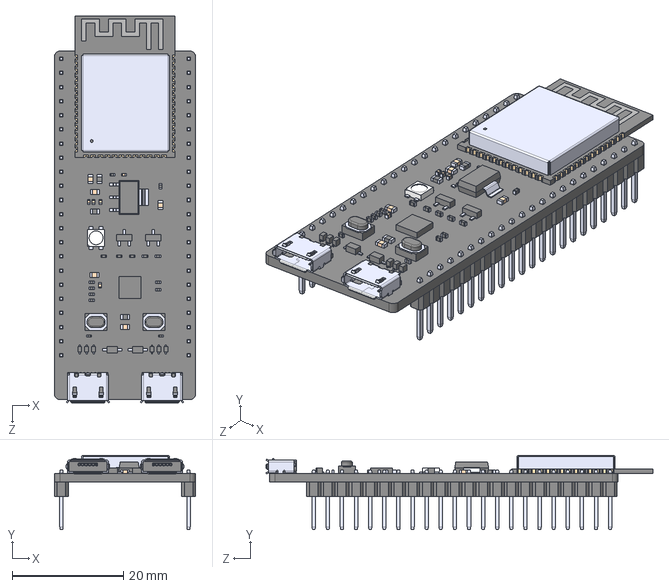
[picture p13: CAD file, 2026-10-16]
hardware/boards/esp32-mini/3dmodels/ESP32-S3-DEVKITC-1-N8R2.step
25.4 x 13.4 x 69.6 mm
