Pytonballoon810/gdoor/hardware/boards/din/enclosure/gdoor-din-keeper.step

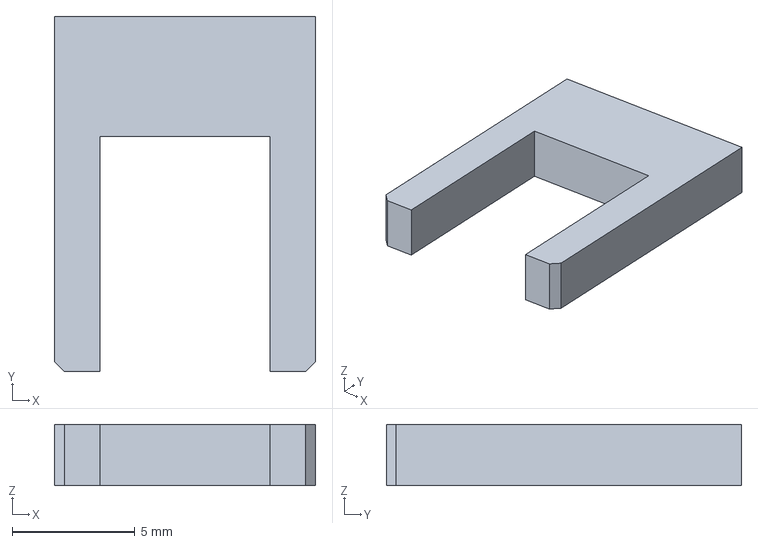
[picture p14: CAD file, 2026-10-24]
hardware/boards/din/enclosure/gdoor-din-keeper.step
10.7 x 14.5 x 2.50 mm
