Pytonballoon810/gdoor/hardware/boards/din/enclosure/gdoor-din-base-accent.stl

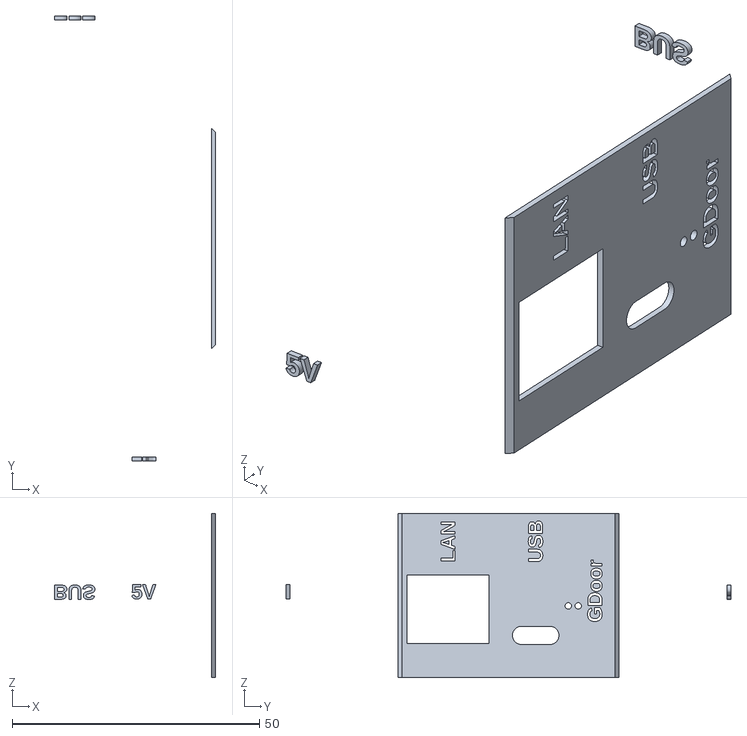
[picture p15: CAD file, 2026-10-24]
hardware/boards/din/enclosure/gdoor-din-base-accent.stl
32.6 x 90.0 x 33.2
