Pytonballoon810/gdoor/hardware/boards/din/enclosure/gdoor-din-base-body.stl

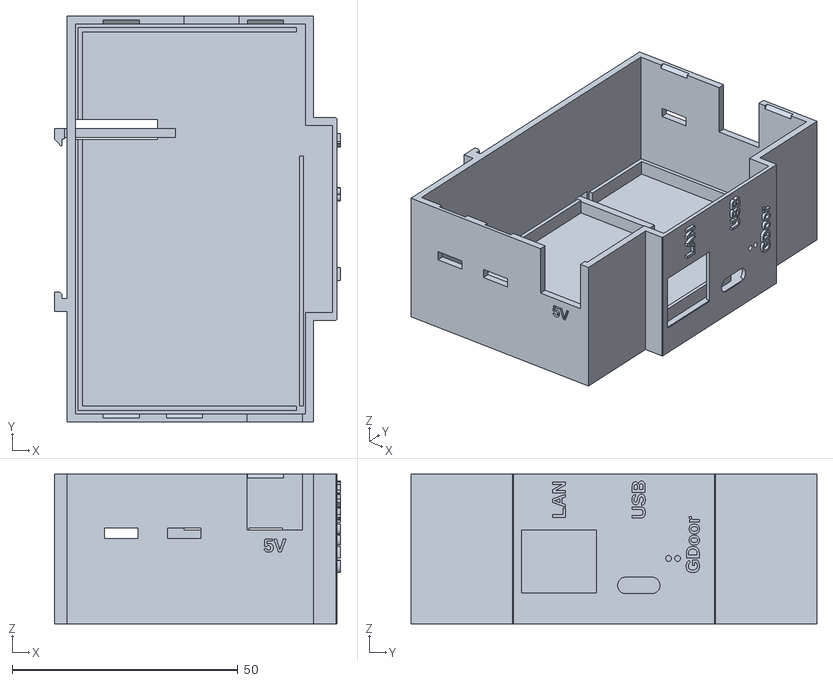
[picture p16: CAD file, 2026-10-24]
hardware/boards/din/enclosure/gdoor-din-base-body.stl
63.4 x 90.0 x 33.2
