Pytonballoon810/gdoor/hardware/boards/din/enclosure/gdoor-din-lid-accent.stl

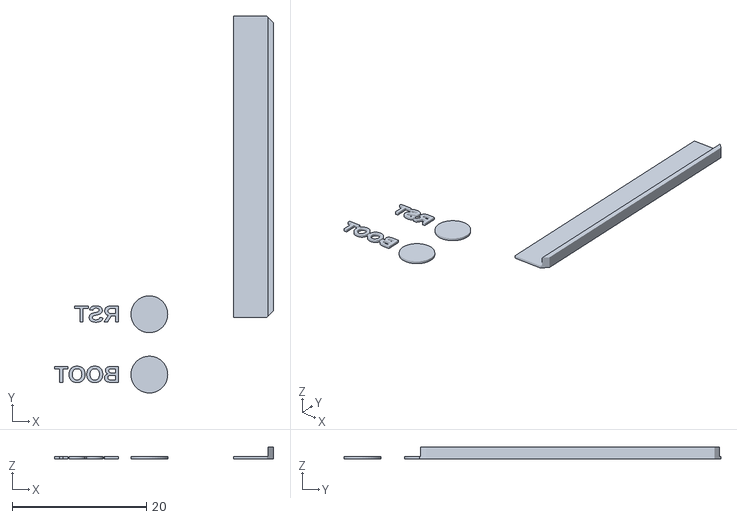
[picture p17: CAD file, 2026-10-24]
hardware/boards/din/enclosure/gdoor-din-lid-accent.stl
32.7 x 56.2 x 1.80
