Pytonballoon810/gdoor/hardware/boards/din/enclosure/plug-3.81-2p-mated.step

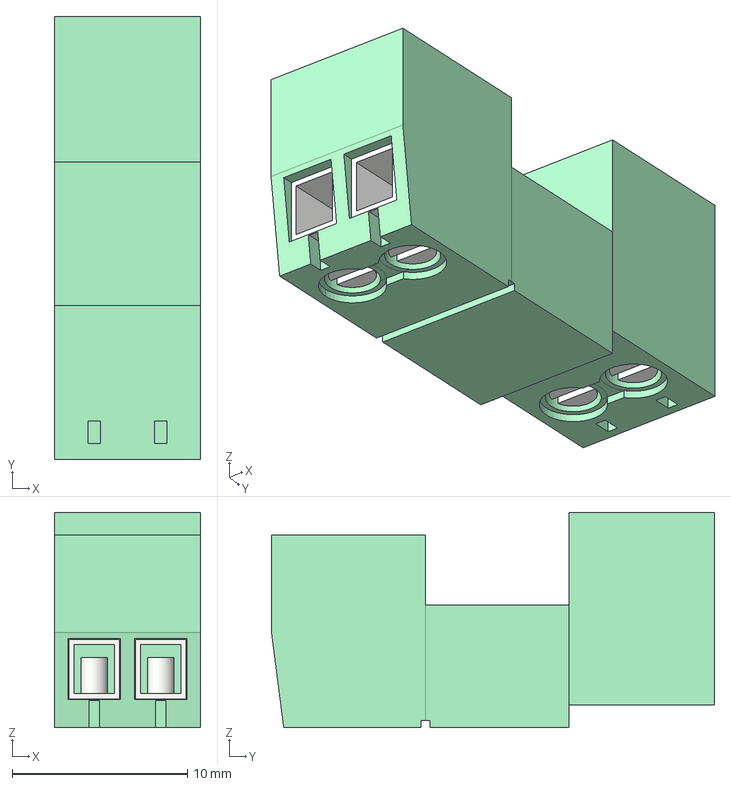
[picture p18: CAD file, 2026-10-23]
hardware/boards/din/enclosure/plug-3.81-2p-mated.step
8.35 x 25.3 x 12.3 mm
