Pytonballoon810/gdoor/hardware/boards/din/enclosure/plug-3.81-2p-female.step

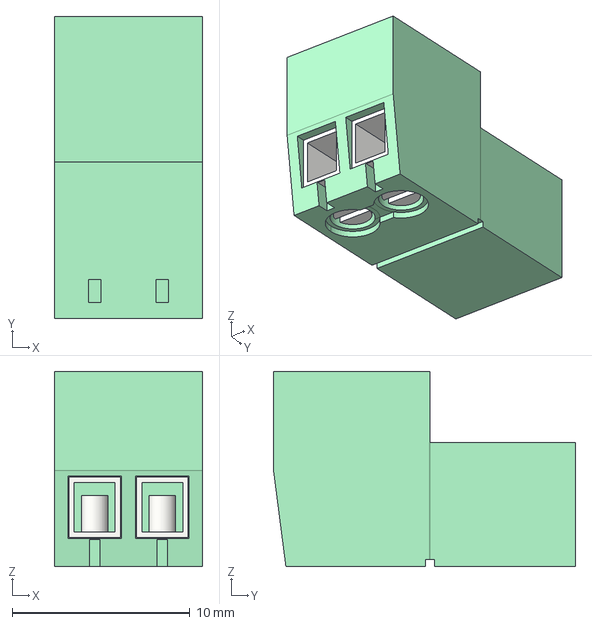
[picture p19: CAD file, 2026-10-23]
hardware/boards/din/enclosure/plug-3.81-2p-female.step
8.35 x 17.0 x 11.0 mm
