Pytonballoon810/gdoor/hardware/boards/din/enclosure/plug-3.81-2p-male.step

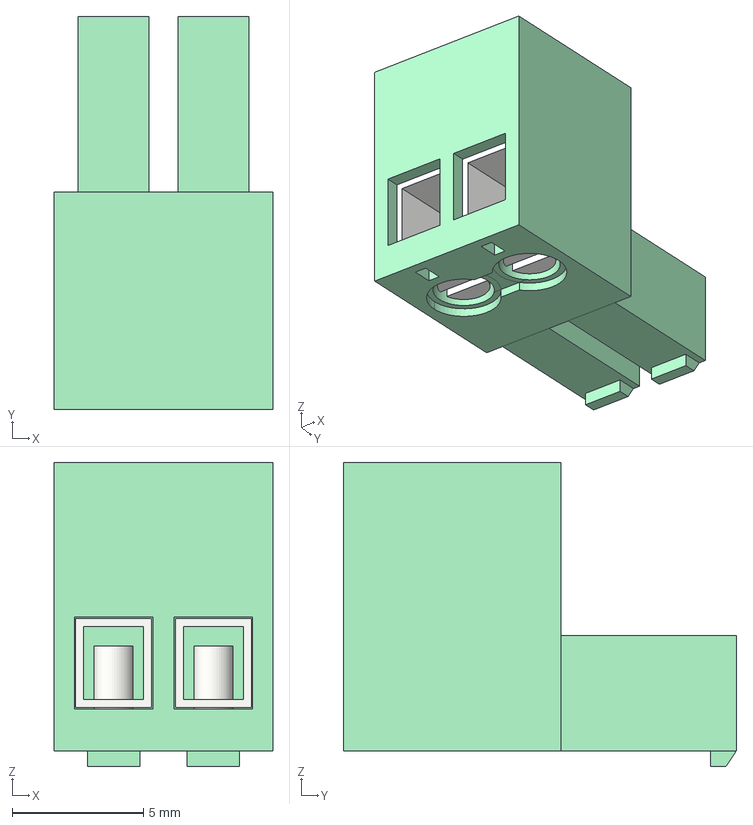
[picture p20: CAD file, 2026-10-23]
hardware/boards/din/enclosure/plug-3.81-2p-male.step
8.35 x 15.0 x 11.6 mm
