Pytonballoon810/gdoor/hardware/boards/din/enclosure/board_ghost.scad

// generated by board_export.py from esp32.kicad_pcb, do not edit
// [ref, side(1=F,-1=B), x0, x1, y0, y1, height, dnp]
board_parts = [
  ["R114", 1, 25.82, 26.98, 64.88, 65.52, 1.2, false],
  ["C9", 1, 28.72, 29.82, 81.06, 81.66, 1.2, false],
  ["R23", 1, 20.35, 21.50, 78.41, 79.05, 1.2, false],
  ["R121", 1, 28.07, 29.23, 61.35, 61.99, 1.2, false],
  ["R30", 1, 18.86, 19.49, 73.54, 74.69, 1.2, false],
  ["C120", 1, 18.85, 19.45, 65.09, 66.19, 1.2, false],
  ["C23", 1, 10.65, 11.25, 42.35, 43.45, 1.2, false],
  ["R17", 1, 28.96, 30.11, 78.00, 78.64, 1.2, false],
  ["R105", 1, 35.66, 36.30, 20.89, 22.04, 1.2, false],
  ["R39", 1, 13.19, 14.34, 44.63, 45.27, 1.2, false],
  ["R118", 1, 40.08, 40.72, 44.92, 46.08, 1.2, false],
  ["R28", 1, 19.15, 19.79, 67.67, 68.83, 1.2, false],
  ["C46", 1, 27.60, 28.20, 42.95, 44.05, 1.2, false],
  ["R16", 1, 26.18, 27.33, 78.59, 79.23, 1.2, false],
  ["C54", 1, 28.10, 29.20, 41.20, 41.80, 1.2, false],
  ["D104", 1, 49.25, 50.95, 30.45, 31.35, 1.2, false],
  ["C113", 1, 27.76, 28.36, 55.70, 56.80, 1.2, false],
  ["J101", 1, 53.00, 60.40, 34.98, 44.02, 3.3, false],
  ["C47", 1, 27.85, 28.45, 38.95, 40.05, 1.2, false],
  ["C57", 1, 4.64, 6.34, 53.97, 57.28, 1.8, false],
  ["R38", 1, 18.42, 19.57, 44.82, 45.46, 1.2, false],
  ["C37", 1, 11.94, 13.04, 33.63, 34.23, 1.2, false],
  ["C40", 1, 21.67, 22.27, 42.28, 43.38, 1.2, false],
  ["R1", 1, 19.75, 20.68, 75.88, 77.58, 1.2, false],
  ["R60", 1, 26.48, 27.12, 38.38, 39.53, 1.2, false],
  ["C104", 1, 37.70, 39.40, 21.25, 22.15, 1.2, false],
  ["R101", 1, 32.84, 33.99, 19.19, 19.83, 1.2, false],
  ["C32", 1, 14.26, 14.86, 62.86, 63.96, 1.2, false],
  ["J1", 1, 5.84, 12.96, 79.44, 86.56, 10.5, false],
  ["R14", 1, 26.32, 27.48, 75.63, 76.27, 1.2, false],
  ["R2", 1, 33.33, 33.97, 72.92, 74.08, 1.2, false],
  ["C27", 1, 8.09, 8.69, 34.12, 35.22, 1.2, false],
  ["SW101", 1, 41.25, 46.55, 19.75, 26.25, 1.6, false],
  ["R15", 1, 26.17, 27.32, 77.06, 77.70, 1.2, false],
  ["C123", 1, 43.89, 44.99, 44.95, 45.55, 1.2, false],
  ["C53", 1, 26.85, 27.95, 36.70, 37.30, 1.2, false],
  ["C114", 1, 27.76, 28.36, 53.45, 54.55, 1.2, false],
  ["C7", 1, 34.85, 35.45, 75.20, 76.30, 1.2, false],
  ["C2", 1, 8.97, 10.07, 77.89, 78.49, 1.2, false],
  ["R116", 1, 17.30, 17.94, 65.08, 66.22, 1.2, false],
  ["R102", 1, 38.68, 39.83, 17.85, 18.49, 1.2, false],
  ["C61", 1, 17.36, 18.46, 63.65, 64.25, 1.2, false],
  ["C42", 1, 7.32, 7.92, 38.26, 39.36, 1.2, false],
  ["C35", 1, 7.42, 8.02, 42.74, 43.84, 1.2, false],
  ["J102", 1, 39.00, 60.40, 49.13, 65.27, 13.5, false],
  ["R13", 1, 12.10, 13.25, 77.68, 78.32, 1.2, false],
  ["C118", 1, 22.85, 23.95, 64.86, 65.46, 1.2, false],
  ["R57", 1, 13.52, 14.68, 48.00, 48.64, 1.2, false],
  ["R11", 1, 24.39, 25.03, 76.03, 77.18, 1.2, false],
  ["R48", 1, 20.16, 21.31, 33.98, 34.62, 1.2, false],
  ["R25", 1, 23.38, 24.53, 81.16, 81.80, 1.2, false],
  ["R106", 1, 28.66, 29.30, 25.58, 26.73, 1.2, false],
  ["R34", 1, 20.63, 21.78, 79.93, 80.57, 1.2, false],
  ["R52", 1, 21.68, 22.83, 29.93, 30.57, 1.2, false],
  ["C17", 1, 15.87, 16.47, 73.61, 74.70, 1.2, false],
  ["R27", 1, 23.35, 24.50, 79.80, 80.44, 1.2, false],
  ["C101", 1, 5.40, 6.30, 10.41, 12.11, 1.2, false],
  ["C116", 1, 11.89, 13.59, 52.05, 52.95, 1.2, false],
  ["C56", 1, 26.85, 27.95, 35.20, 35.80, 1.2, false],
  ["R73", 1, 3.01, 3.65, 78.17, 79.33, 1.2, false],
  ["C52", 1, 26.85, 27.95, 33.70, 34.30, 1.2, false],
  ["C103", 1, 6.59, 7.19, 13.46, 14.56, 1.2, false],
  ["C59", 1, 7.30, 9.90, 52.35, 55.65, 2.6, false],
  ["C10", 1, 20.60, 21.70, 82.90, 83.50, 1.2, false],
  ["U2", 1, 7.80, 9.50, 67.25, 70.25, 1.2, false],
  ["R19", 1, 31.32, 31.96, 78.50, 79.65, 1.2, false],
  ["J103", 1, 49.18, 51.82, 13.48, 28.82, 11.0, false],
  ["R111", 1, 26.79, 27.43, 48.92, 50.08, 1.2, false],
  ["C24", 1, 10.40, 11.50, 44.60, 45.20, 1.2, false],
  ["FB101", 1, 16.55, 18.25, 50.14, 51.04, 1.2, false],
  ["C112", 1, 27.86, 28.76, 58.40, 60.10, 1.2, false],
  ["D1", 1, 7.08, 11.72, 73.10, 76.90, 1.8, false],
  ["C13", 1, 8.99, 10.09, 71.20, 71.80, 1.2, false],
  ["C21", 1, 24.97, 26.67, 41.47, 44.77, 1.8, false],
  ["C107", 1, 14.69, 15.29, 53.70, 54.80, 1.2, false],
  ["R7", 1, 3.77, 4.41, 75.57, 76.72, 1.2, false],
  ["C1", 1, 22.55, 23.45, 75.24, 76.94, 1.2, false],
  ["R29", 1, 19.59, 20.74, 69.93, 70.57, 1.2, false],
  ["C16", 1, 6.24, 7.34, 71.20, 71.80, 1.2, false],
  ["R104", 1, 39.92, 41.07, 33.58, 34.22, 1.2, false],
  ["D2", 1, 37.85, 40.95, 80.65, 85.35, 2.4, false],
  ["C43", 1, 9.65, 10.25, 35.58, 36.68, 1.2, false],
  ["C45", 1, 17.20, 18.30, 33.65, 34.25, 1.2, false],
  ["R46", 1, 17.37, 18.52, 30.43, 31.07, 1.2, false],
  ["C4", 1, 3.84, 4.44, 73.02, 74.12, 1.2, false],
  ["R122", 1, 28.07, 29.23, 51.76, 52.40, 1.2, false],
  ["R53", 1, 21.38, 22.53, 31.43, 32.07, 1.2, false],
  ["C124", 1, 43.10, 46.40, 41.10, 42.80, 1.8, false],
  ["R112", 1, 28.01, 29.16, 62.89, 63.53, 1.2, false],
  ["C121", 1, 43.50, 44.60, 46.36, 46.96, 1.2, false],
  ["R42", 1, 22.12, 22.76, 39.65, 40.80, 1.2, false],
  ["C8", 1, 28.91, 30.01, 79.54, 80.14, 1.2, false],
  ["R117", 1, 41.18, 41.82, 44.92, 46.08, 1.2, false],
  ["C29", 1, 30.95, 32.65, 39.55, 42.85, 1.8, false],
  ["U103", 1, 33.50, 37.30, 23.10, 29.90, 1.8, false],
  ["R18", 1, 26.07, 27.22, 79.95, 80.59, 1.2, false],
  ["R21", 1, 22.93, 24.08, 82.88, 83.52, 1.2, false],
  ["R36", 1, 24.52, 25.68, 49.43, 50.07, 1.2, false],
  ["R4", 1, 2.86, 3.79, 70.05, 71.75, 1.2, false],
  ["C33", 1, 14.29, 14.89, 60.33, 61.42, 1.2, false],
  ["D101", 1, 47.60, 50.70, 36.47, 41.17, 2.4, false],
  ["R109", 1, 28.20, 28.84, 48.92, 50.08, 1.2, false],
  ["C26", 1, 9.15, 10.25, 40.65, 41.25, 1.2, false],
  ["U1", 1, 26.68, 28.12, 67.35, 69.65, 1.2, false],
  ["R20", 1, 25.81, 27.51, 81.32, 82.24, 1.2, false],
  ["J4", 1, 41.84, 48.96, 79.44, 86.56, 10.5, false],
  ["R59", 1, 7.32, 8.47, 36.38, 37.02, 1.2, false],
  ["R44", 1, 29.10, 29.74, 36.30, 37.45, 1.2, false],
  ["C6", 1, 5.24, 5.84, 67.70, 68.80, 1.2, false],
  ["C48", 1, 17.45, 18.55, 31.90, 32.50, 1.2, false],
  ["R22", 1, 15.22, 16.37, 79.46, 80.10, 1.2, false],
  ["U101", 1, 8.35, 26.45, 2.50, 28.05, 3.2, false],
  ["R43", 1, 23.53, 24.17, 38.47, 39.62, 1.2, false],
  ["R51", 1, 19.65, 20.30, 30.42, 31.58, 1.2, false],
  ["C55", 1, 27.10, 28.20, 32.20, 32.80, 1.2, false],
  ["R119", 1, 45.73, 46.88, 46.32, 46.96, 1.2, false],
  ["C102", 1, 3.80, 4.40, 10.71, 11.81, 1.2, false],
  ["R32", 1, 9.63, 10.27, 32.83, 33.97, 1.2, false],
  ["R31", 1, 17.97, 19.12, 79.88, 80.52, 1.2, false],
  ["Q1", 1, 22.15, 25.15, 68.30, 69.70, 1.2, false],
  ["C15", 1, 35.35, 36.45, 69.70, 70.30, 1.2, false],
  ["C14", 1, 14.37, 14.97, 73.61, 74.70, 1.2, false],
  ["R6", 1, 33.43, 34.07, 70.15, 71.30, 1.2, false],
  ["R3", 1, 4.53, 5.46, 79.42, 81.12, 1.2, false],
  ["R110", 1, 29.91, 31.06, 44.18, 44.82, 1.2, false],
  ["C50", 1, 22.12, 22.72, 35.90, 37.00, 1.2, false],
  ["C111", 1, 16.49, 17.59, 51.77, 52.37, 1.2, false],
  ["R8", 1, 33.35, 33.99, 75.67, 76.83, 1.2, false],
  ["R33", 1, 33.84, 34.99, 68.27, 68.91, 1.2, false],
  ["U104", 1, 17.35, 24.45, 54.45, 61.55, 1.6, false],
  ["C3", 1, 36.35, 36.95, 71.45, 72.55, 1.2, false],
  ["C108", 1, 13.64, 14.74, 50.70, 51.30, 1.2, false],
  ["R54", 1, 23.68, 24.32, 31.67, 32.83, 1.2, false],
  ["C115", 1, 22.10, 23.20, 50.54, 51.14, 1.2, false],
  ["R26", 1, 17.37, 18.01, 73.42, 74.58, 1.2, false],
  ["C51", 1, 11.85, 12.95, 31.70, 32.30, 1.2, false],
  ["R9", 1, 34.84, 35.48, 72.38, 73.53, 1.2, false],
  ["R37", 1, 16.12, 17.27, 46.88, 47.52, 1.2, false],
  ["C110", 1, 19.30, 21.00, 46.69, 47.59, 1.2, false],
  ["R49", 1, 15.66, 16.30, 30.74, 31.89, 1.2, false],
  ["C105", 1, 27.95, 28.85, 45.70, 47.40, 1.2, false],
  ["R40", 1, 11.88, 12.52, 47.94, 49.09, 1.2, false],
  ["R113", 1, 28.07, 29.23, 64.28, 64.92, 1.2, false],
  ["C49", 1, 14.34, 14.94, 30.77, 31.87, 1.2, false],
  ["U6", 1, 12.90, 16.90, 67.25, 72.25, 1.8, false],
  ["C31", 1, 22.37, 23.72, 45.95, 48.05, 1.2, false],
  ["C22", 1, 15.87, 16.97, 45.42, 46.03, 1.2, false],
  ["Q2", 1, 29.65, 32.65, 69.30, 70.70, 1.2, false],
  ["U5", 1, 14.35, 18.45, 37.45, 41.55, 1.2, false],
  ["R58", 1, 13.52, 14.68, 49.43, 50.07, 1.2, false],
  ["C25", 1, 8.81, 9.41, 42.40, 43.50, 1.2, false],
  ["R50", 1, 25.18, 25.82, 30.33, 31.48, 1.2, false],
  ["C117", 1, 20.60, 21.70, 64.86, 65.46, 1.2, false],
  ["C34", 1, 10.02, 10.62, 38.36, 39.46, 1.2, false],
  ["R103", 1, 50.09, 50.73, 43.17, 44.33, 1.2, false],
  ["C11", 1, 22.80, 23.90, 71.64, 72.24, 1.2, false],
  ["C44", 1, 11.94, 13.04, 30.28, 30.88, 1.2, false],
  ["SW102", 1, 41.25, 46.55, 10.75, 17.25, 1.6, false],
  ["R45", 1, 24.23, 24.87, 46.62, 47.78, 1.2, false],
  ["U7", 1, 7.50, 11.30, 58.60, 65.40, 1.8, false],
  ["C119", 1, 19.85, 20.95, 50.54, 51.14, 1.2, false],
  ["R5", 1, 4.84, 5.99, 77.86, 78.50, 1.2, false],
  ["R24", 1, 22.98, 24.13, 78.41, 79.05, 1.2, false],
  ["D103", 1, 49.25, 50.95, 32.45, 33.35, 1.2, false],
  ["C38", 1, 23.55, 24.15, 35.70, 36.80, 1.2, false],
  ["C109", 1, 14.70, 15.30, 57.96, 59.06, 1.2, false],
  ["R74", 1, 25.47, 26.11, 46.82, 47.97, 1.2, false],
  ["C5", 1, 22.80, 23.90, 73.14, 73.74, 1.2, false],
  ["R123", 1, 47.93, 48.57, 44.67, 45.83, 1.2, false],
  ["R107", 1, 11.04, 12.19, 50.56, 51.19, 1.2, false],
  ["Y101", 1, 11.19, 13.79, 54.10, 57.40, 1.2, false],
  ["R35", 1, 20.70, 21.34, 67.67, 68.83, 1.2, false],
  ["C20", 1, 29.80, 32.40, 73.29, 76.59, 2.6, false],
  ["R108", 1, 48.19, 49.34, 46.38, 47.02, 1.2, false],
  ["C122", 1, 42.90, 44.00, 43.45, 44.05, 1.2, false],
  ["R120", 1, 46.03, 46.67, 44.17, 45.33, 1.2, false],
  ["R12", 1, 4.34, 4.98, 70.42, 71.58, 1.2, false],
  ["C41", 1, 23.31, 23.91, 42.39, 43.49, 1.2, false],
  ["U3", 1, 26.05, 27.75, 71.75, 74.75, 1.2, false],
  ["R47", 1, 22.90, 24.05, 33.95, 34.59, 1.2, false],
  ["C19", 1, 15.14, 18.44, 75.95, 78.55, 2.6, false],
  ["C12", 1, 20.65, 21.55, 72.34, 74.04, 1.2, false],
  ["C39", 1, 24.97, 25.57, 37.56, 38.66, 1.2, false],
  ["C106", 1, 40.62, 41.98, 28.45, 30.55, 1.2, false],
  ["R41", 1, 8.63, 9.27, 38.16, 39.31, 1.2, false],
  ["C36", 1, 14.50, 15.60, 33.01, 33.61, 1.2, false],
  ["R10", 1, 3.88, 4.52, 67.67, 68.83, 1.2, false],
  ["U102", 1, 42.92, 44.62, 34.59, 37.59, 1.2, false],
  ["R115", 1, 28.07, 29.23, 65.70, 66.34, 1.2, false],
  ["C18", -1, 25.98, 27.08, 72.87, 73.47, 1.2, true],
];
board_pin_stub = 3.0;
board_pins = [
  [53.57, 43.82],
  [57.75, 43.82],
  [53.57, 35.18],
  [57.75, 35.18],
  [11.15, 83.00],
  [7.65, 83.00],
  [43.09, 61.64],
  [40.55, 60.38],
  [43.09, 59.10],
  [40.55, 57.84],
  [43.09, 56.56],
  [40.55, 55.30],
  [43.09, 54.02],
  [40.55, 52.76],
  [54.35, 63.83],
  [54.35, 61.28],
  [54.35, 53.11],
  [54.35, 50.58],
  [46.40, 64.94],
  [46.40, 49.45],
  [50.50, 27.50],
  [50.50, 24.96],
  [50.50, 22.42],
  [50.50, 19.88],
  [50.50, 17.34],
  [50.50, 14.80],
  [47.15, 83.00],
  [43.65, 83.00],
  [14.50, 17.01],
  [14.50, 18.41],
  [15.20, 16.31],
  [15.20, 17.71],
  [15.20, 19.11],
  [15.90, 17.01],
  [15.90, 18.41],
  [16.60, 16.31],
  [16.60, 17.71],
  [16.60, 19.11],
  [17.30, 17.01],
  [17.30, 18.41],
];
