Pytonballoon810/gdoor/(list of files, cad)

Other CAD files:
hardware/boards/din/enclosure/gdoor-din-full.step
hardware/boards/din/PowerModule.step
hardware/boards/din/3dmodels/User Library-WJ127-5_0-2P.step
hardware/boards/din/enclosure/gdoor-din-base.step
hardware/boards/din/3dmodels/screwterminal.stp
hardware/boards/din/3dmodels/screwterminal_3_5mm_2.STEP
hardware/boards/din/enclosure/gdoor-din-base.stl
hardware/boards/din/enclosure/gdoor-din-keeper.stl
hardware/boards/din/enclosure/gdoor-din-lid.stl
hardware/boards/esp32-mini/3dmodels/screwterminal.stp
hardware/boards/esp32-mini/3dmodels/screwterminal_3_5mm_2.STEP
