Pytonballoon810/gdoor/hardware/boards/din/esp32.kicad_pcb

## KiCad design hardware/boards/din/esp32.kicad_pcb (2026-10-22)

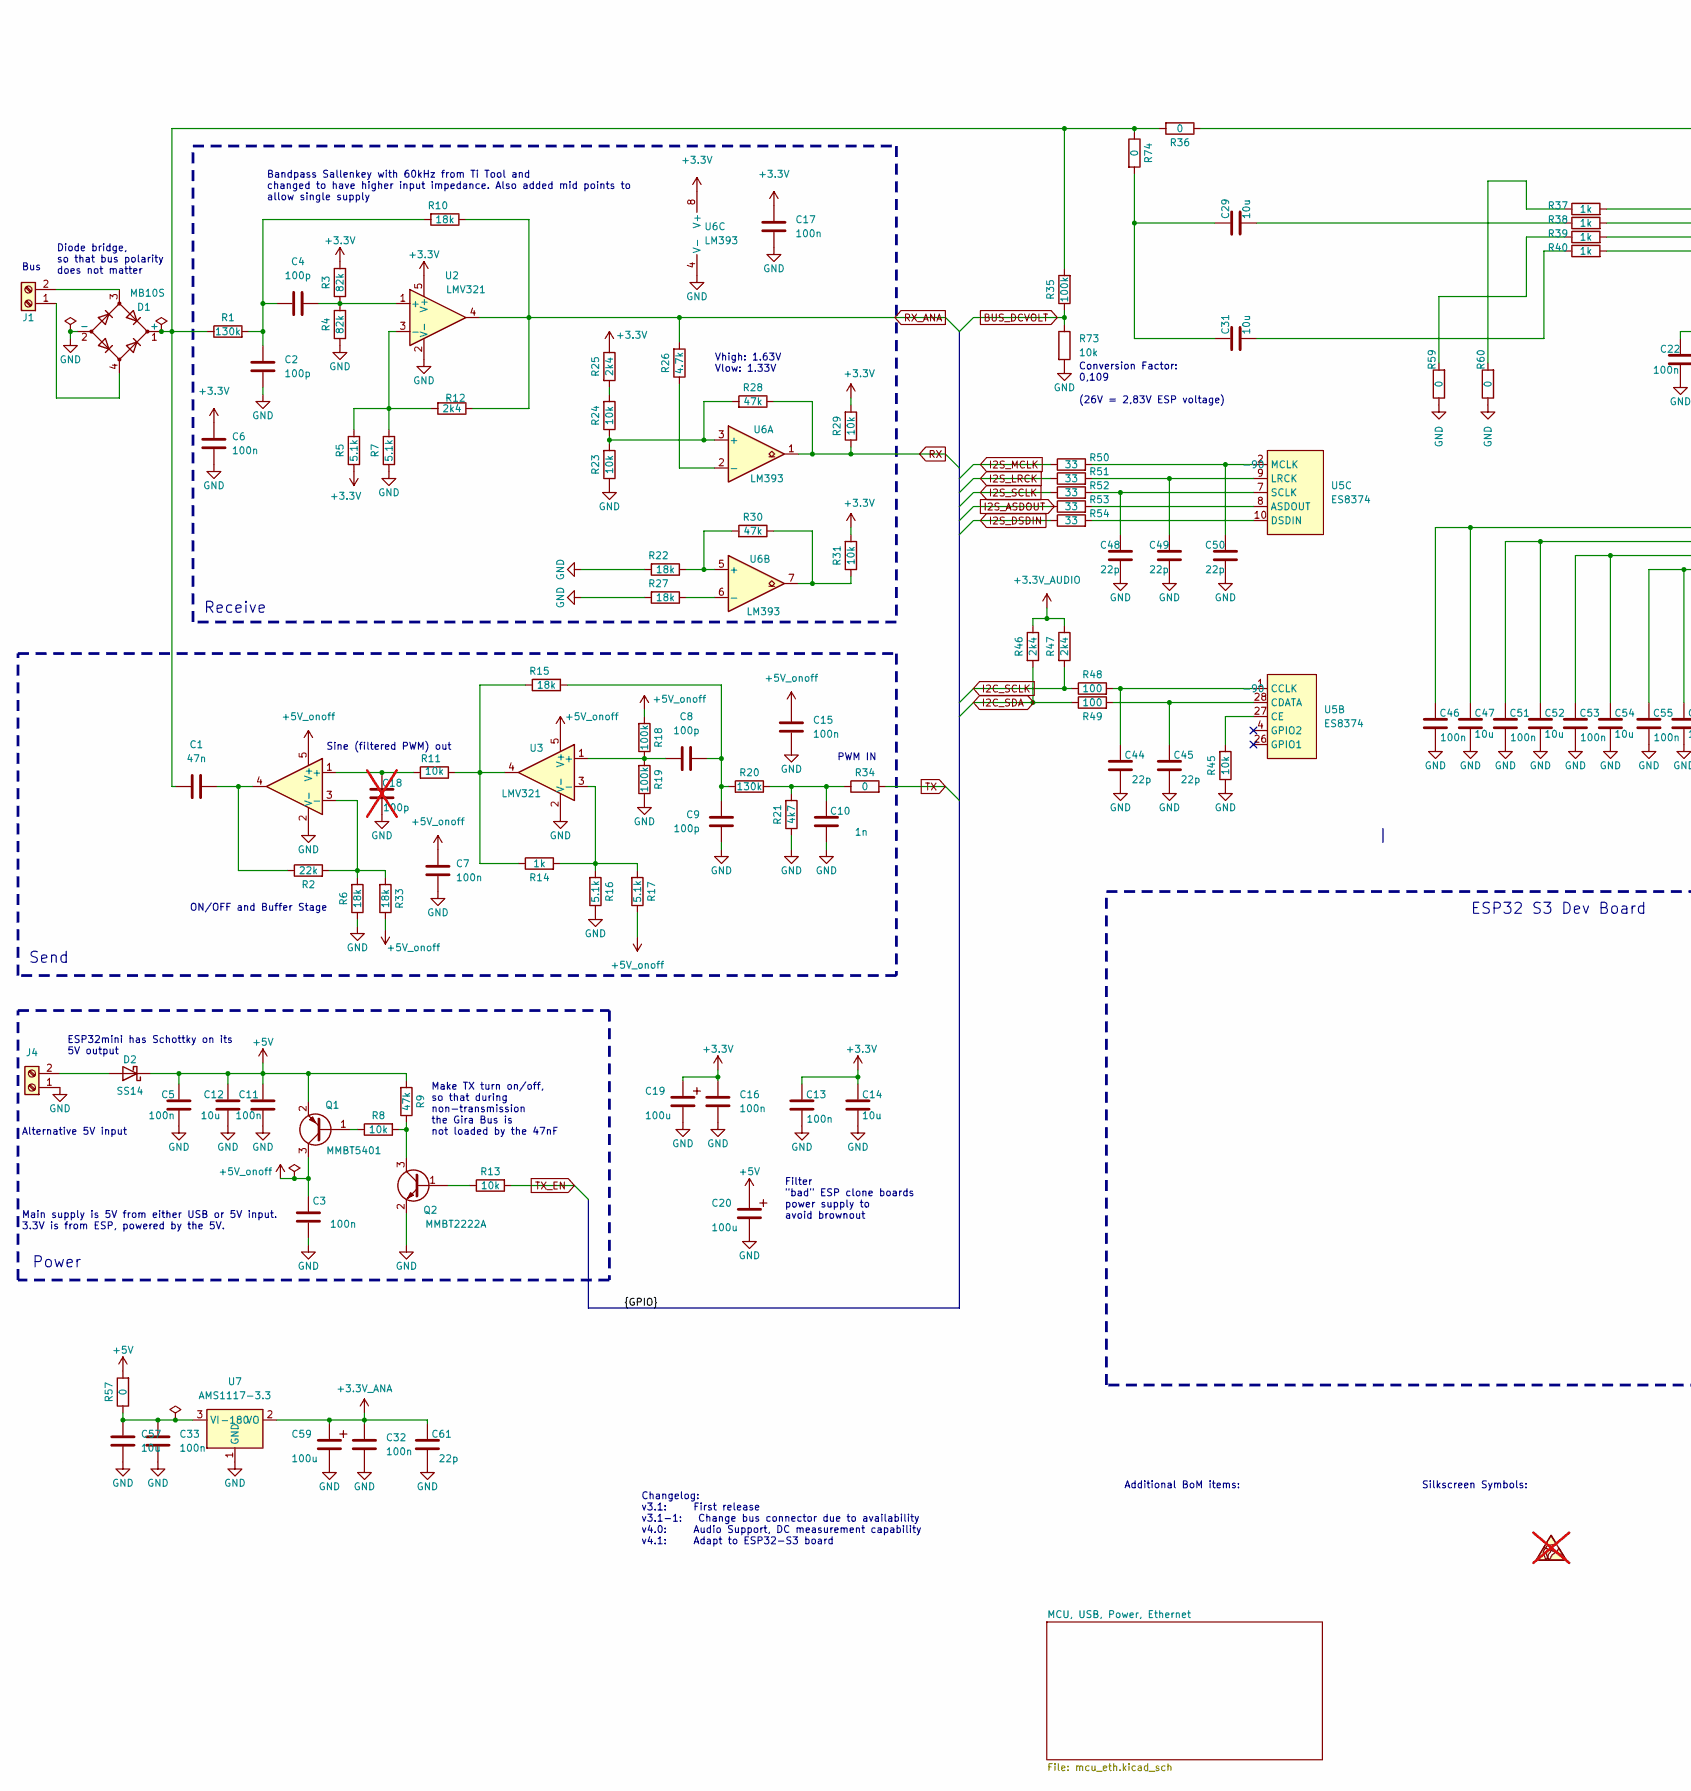
[picture p21: schematic esp32.kicad_sch, ESP32 Mini, part in row 1, column 1]

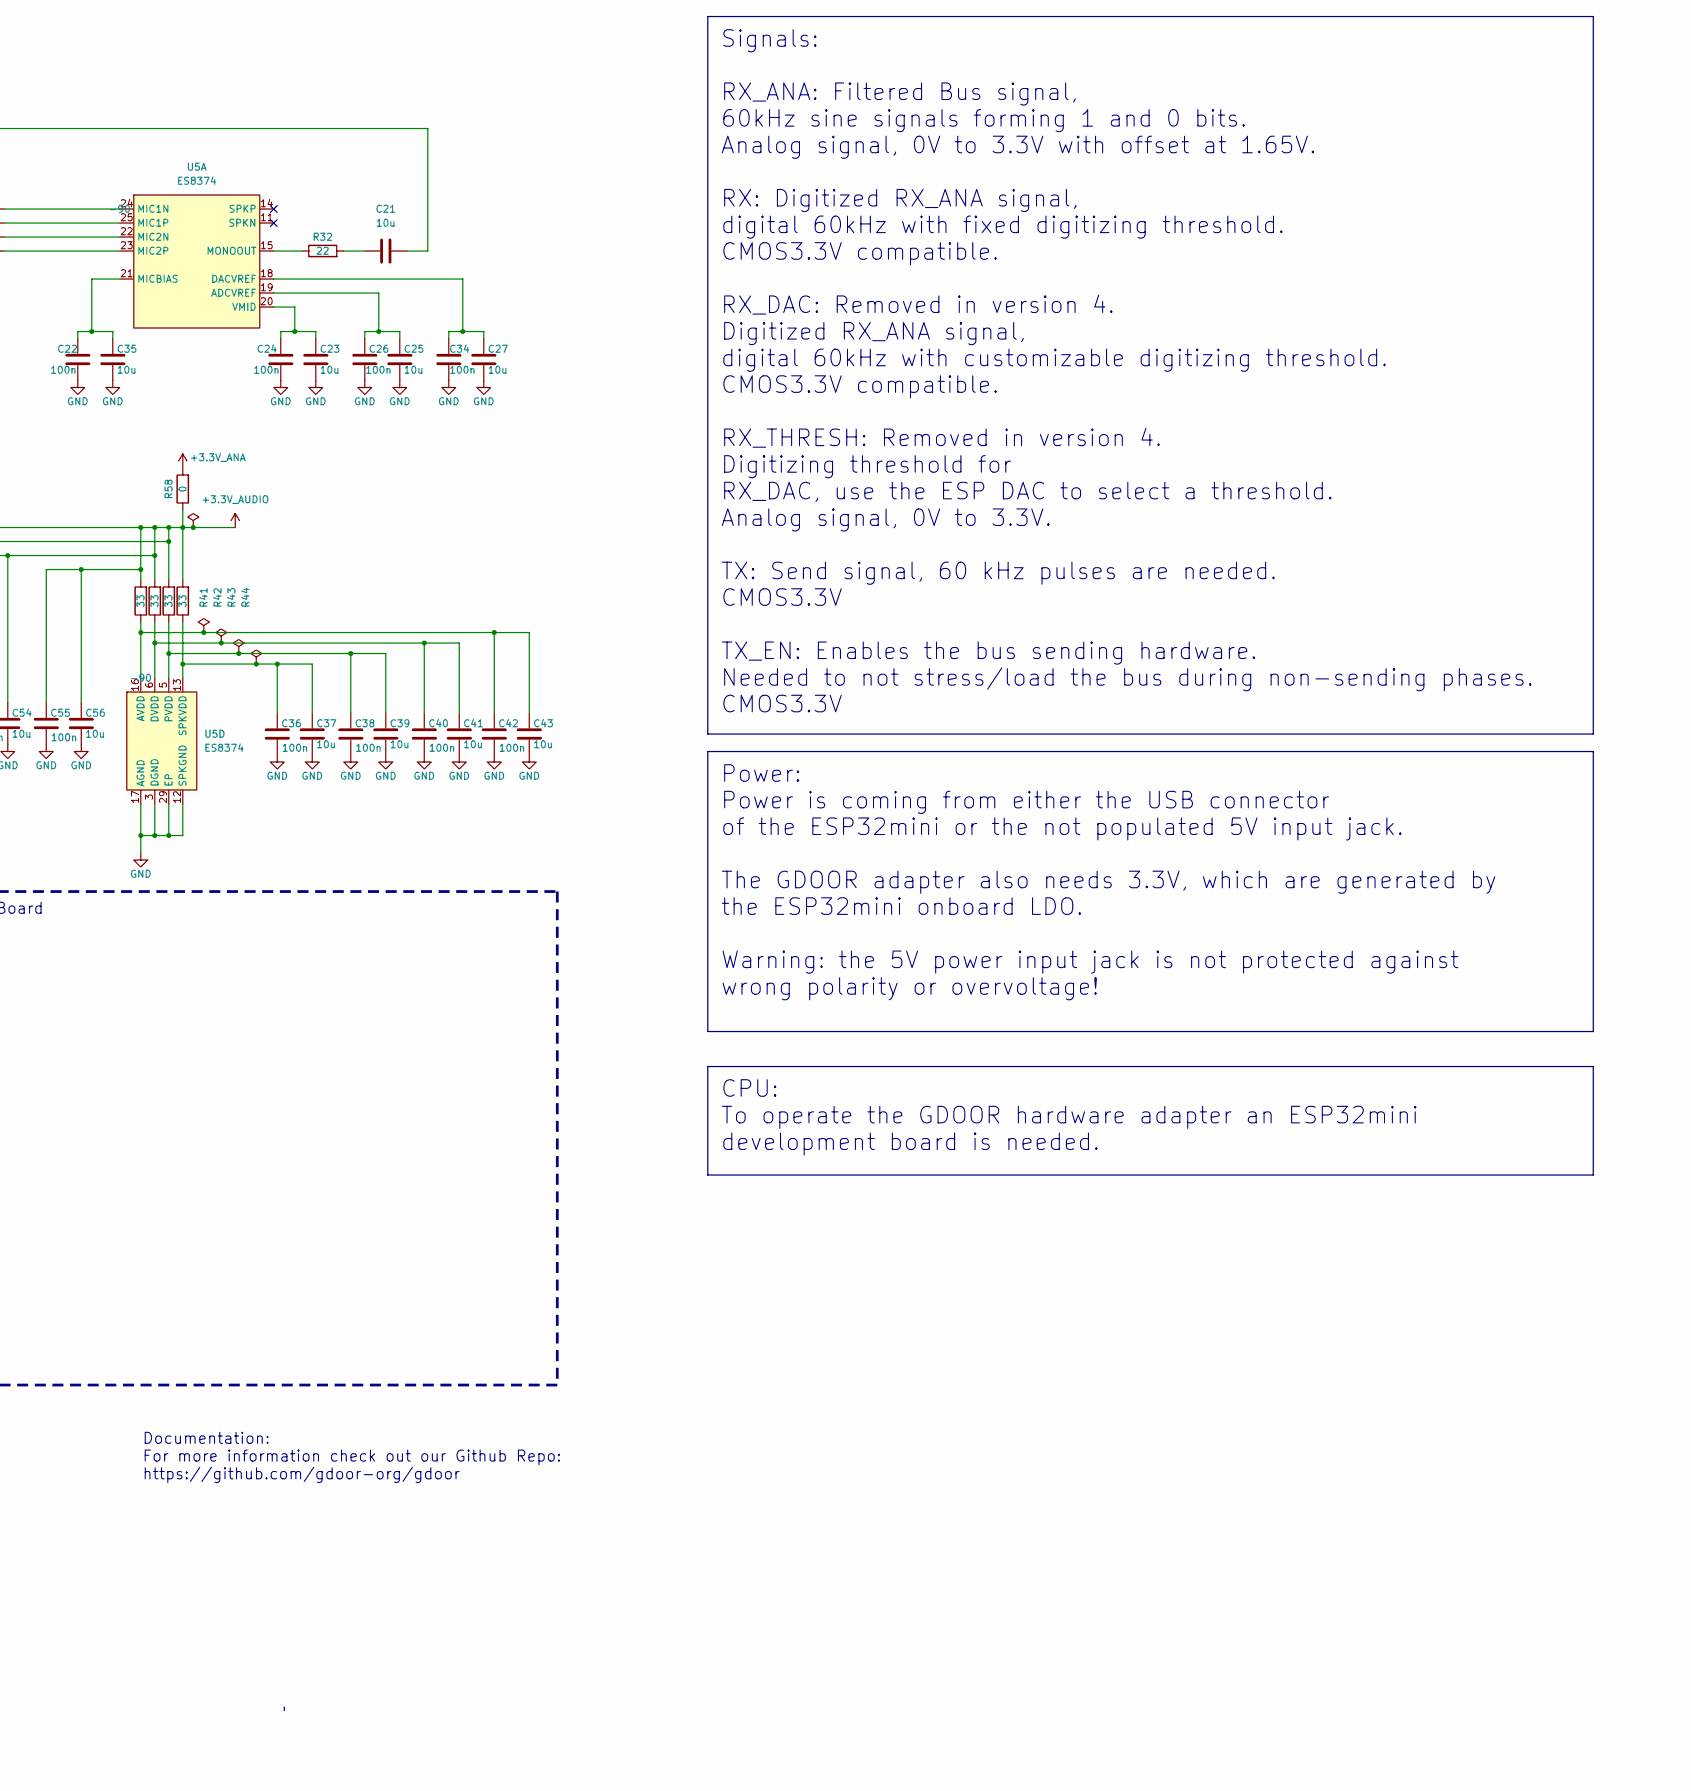
[picture p22: schematic esp32.kicad_sch, ESP32 Mini, part in row 1, column 2]

Parts:
C1: 47n; C_0603_1608Metric_Pad1.08x0.95mm_HandSolder; MPN C1622
C2, C4, C8, C9: 100p; C_0402_1005Metric_Pad0.74x0.62mm_HandSolder; MPN C1546
C3, C5, C6, C7, C11, C13, C15, C16, C17, C36, C38, C40, C42, C46, C51, C53, C55: 100n; C_0402_1005Metric_Pad0.74x0.62mm_HandSolder; MPN C307331
C10: 1n; C_0402_1005Metric_Pad0.74x0.62mm_HandSolder; MPN C1523
C12: 10u; C_0603_1608Metric_Pad1.08x0.95mm_HandSolder; MPN C96446
C14, C23, C25, C27, C35, C37, C39, C41, C43, C47, C52, C54, C56: 10u; C_0402_1005Metric_Pad0.74x0.62mm_HandSolder; MPN C15525
C18: 100p; C_0402_1005Metric_Pad0.74x0.62mm_HandSolder; MPN C1546; not fitted
C19, C20, C59: 100u; C_1210_3225Metric_Pad1.33x2.70mm_HandSolder; MPN C23742
C21, C57: 10u; C_1206_3216Metric_Pad1.33x1.80mm_HandSolder; MPN C13585
C22, C24, C26, C32, C33, C34: 100n; C_0402_1005Metric_Pad0.74x0.62mm_HandSolder; MPN C1525
C29: 10u; C_1206_3216Metric; MPN C13585
C31: 10u; C_0805_2012Metric; MPN C440198
C44, C45, C48, C49, C50, C61: 22p; C_0402_1005Metric_Pad0.74x0.62mm_HandSolder; MPN C1555
D1: MB10S; SOIC-4_4.55x3.7mm_P2.54mm; MPN C2488
D2: SS14; D_SMA; MPN C2480
J1: PlugIn_Terminal_Screw; anschlussklemme2x1_3_5; MPN C695629; JLCPCB Rotation Offset 90
J4: 5V_IN; anschlussklemme2x1_3_5; MPN C695629; JLCPCB Rotation Offset 90
Q1: MMBT5401; SOT-23; MPN C8326
Q2: MMBT2222A; SOT-23; MPN C8512
R1, R20: 130k; R_0603_1608Metric; MPN C22795
R2: 22k; R_0402_1005Metric_Pad0.72x0.64mm_HandSolder; MPN C25768
R3, R4: 82k; R_0603_1608Metric; MPN C23254
R5, R7, R16, R17: 5.1k; R_0402_1005Metric_Pad0.72x0.64mm_HandSolder; MPN C25905
R6, R10, R15, R22, R27, R33: 18k; R_0402_1005Metric_Pad0.72x0.64mm_HandSolder; MPN C25762
R8, R11, R13, R23, R24, R29, R31, R45, R73: 10k; R_0402_1005Metric_Pad0.72x0.64mm_HandSolder; MPN C25744
R9, R28, R30: 47k; R_0402_1005Metric_Pad0.72x0.64mm_HandSolder; MPN C25792
R12, R25, R46, R47: 2k4; R_0402_1005Metric_Pad0.72x0.64mm_HandSolder; MPN C25882
R14, R37, R38, R39, R40: 1k; R_0402_1005Metric_Pad0.72x0.64mm_HandSolder; MPN C11702
R18, R19, R35: 100k; R_0402_1005Metric_Pad0.72x0.64mm_HandSolder; MPN C25741
R21: 4k7; R_0402_1005Metric_Pad0.72x0.64mm_HandSolder; MPN C25900
R26: 4.7k; R_0402_1005Metric_Pad0.72x0.64mm_HandSolder; MPN C25900
R32: 22; R_0402_1005Metric_Pad0.72x0.64mm_HandSolder; MPN C25092
R34, R36, R57, R58, R59, R60, R74: 0; R_0402_1005Metric_Pad0.72x0.64mm_HandSolder; MPN C17168
R41, R42, R43, R44, R50, R51, R52, R53, R54: 33; R_0402_1005Metric_Pad0.72x0.64mm_HandSolder; MPN C25105
R48, R49: 100; R_0402_1005Metric_Pad0.72x0.64mm_HandSolder; MPN C25076
S1: SYM_ESD_Small; ESD-Logo_6.6x6mm_SilkScreen; not fitted
U1: TLV9351; SOT-353_SC-70-5; MPN C4367425; JLCPCB Rotation Offset 180
U2, U3: LMV321; SOT-23-5; MPN C7972
U5: ES8374; QFN-28-1EP_4x4mm_P0.45mm_EP2.4x2.4mm; MPN C365738; JlcRotOffset -90
U6: LM393; SOIC-8_3.9x4.9mm_P1.27mm; MPN C7955; JlcRotOffset -90
U7: AMS1117-3.3; SOT-223-3_TabPin2; MPN C6186; JlcRotOffset -180

Connections:
+3.3V: C6.1, C13.2, C14.2, C16.1, C17.1, C19.1, R3.2, R5.1, R25.1, R29.2, R31.2, U2.5 (V+), U6.8 (V+); also elsewhere on the board
+3.3V_ANA: C32.1, C59.1, C61.2, R58.2, U7.2 (VO)
+3.3V_AUDIO: C46.2, C47.2, C51.2, C52.2, C53.2, C54.2, C55.2, C56.2, R41.2, R42.2, R43.2, R44.2, R46.1, R47.1, R58.1
+5V: C5.1, C11.2, C12.2, C20.1, D2.1 (K), Q1.2 (E1), R9.2, R57.2; also elsewhere on the board
+5V_onoff: C3.1, C7.1, C15.1, Q1.3 (C1), R17.1, R18.2, R33.1, U1.5 (V+), U3.5 (V+)
BUS_DCVOLT: R35.1, R73.1; also elsewhere on the board
GND: C2.1, C3.2, C5.2, C6.2, C7.2, C9.1, C10.1, C11.1, C12.1, C13.1, C14.1, C15.2, C16.2, C17.2, C18.1, C19.2, C20.2, C22.2, C23.1, C24.2, C25.1, C26.2, C27.1, C32.2, C33.2, C34.2, C35.1, C36.1, C37.1, C38.1, C39.1, C40.1, C41.1, C42.1, C43.1, C44.1, C45.1, C46.1, C47.1, C48.1, C49.1, C50.1, C51.1, C52.1, C53.1, C54.1, C55.1, C56.1, C57.1, C59.2, C61.1, D1.2 (-), J4.1, Q2.2 (E), R4.1, R6.1, R7.1, R16.1, R19.1, R21.1, R22.2, R23.1, R27.2, R45.1, R59.1, R60.1, R73.2, U1.2 (V-), U2.2 (V-), U3.2 (V-), U5.3 (DGND), U5.12 (SPKGND), U5.17 (AGND), U5.29 (EP), U6.4 (V-), U7.1 (GND); also elsewhere on the board
I2C_SCLK: R47.2, R48.1; also elsewhere on the board
I2C_SDA: R46.2, R49.1; also elsewhere on the board
I2S_ASDOUT: R53.1; also elsewhere on the board
I2S_DSDIN: R54.1; also elsewhere on the board
I2S_LRCK: R51.1; also elsewhere on the board
I2S_MCLK: R50.1; also elsewhere on the board
I2S_SCLK: R52.1; also elsewhere on the board
unnamed: C1.1, R2.1, U1.4
unnamed: C2.2, C4.2, R1.2, R10.2
unnamed: C8.2, C9.2, R15.2, R20.2
unnamed: C10.2, R20.1, R21.2, R34.1
unnamed: C21.1, R32.2
unnamed: C21.2, R36.1
unnamed: C29.1, R38.1
unnamed: C29.2, C31.2, R74.2
unnamed: C31.1, R40.1
unnamed: C1.2, D1.1 (+), R1.1, R35.2, R36.2, R74.1
unnamed: D2.2 (A), J4.2
unnamed: D1.4, J1.1
unnamed: D1.3, J1.2
unnamed: Q1.1 (B1), R8.1
unnamed: Q2.1 (B), R13.1
unnamed: Q2.3 (C), R8.2, R9.1
unnamed: R11.1, R14.1, R15.1, U3.4
unnamed: R24.2, R25.2
unnamed: R30.1, R31.1, U6.7
unnamed: R37.1, R60.2
unnamed: R39.1, R59.2
unnamed: C18.2, R11.2, U1.1 (+)
unnamed: R2.2, R6.2, R33.2, U1.3 (-)
unnamed: C4.1, R3.1, R4.2, U2.1 (+)
unnamed: R5.2, R7.2, R12.2, U2.3 (-)
unnamed: C8.1, R18.1, R19.2, U3.1 (+)
unnamed: R14.2, R16.2, R17.2, U3.3 (-)
unnamed: C25.2, C26.1, U5.19 (ADCVREF)
unnamed: C27.2, C34.1, U5.18 (DACVREF)
unnamed: R37.2, U5.24 (MIC1N)
unnamed: R38.2, U5.25 (MIC1P)
unnamed: R39.2, U5.22 (MIC2N)
unnamed: R40.2, U5.23 (MIC2P)
unnamed: C22.1, C35.2, U5.21 (MICBIAS)
unnamed: R32.1, U5.15 (MONOOUT)
unnamed: C23.2, C24.1, U5.20 (VMID)
unnamed: C44.2, R48.2, U5.1 (CCLK)
unnamed: C45.2, R49.2, U5.28 (CDATA)
unnamed: R45.2, U5.27 (CE)
unnamed: R53.2, U5.8 (ASDOUT)
unnamed: R54.2, U5.10 (DSDIN)
unnamed: C49.2, R51.2, U5.9 (LRCK)
unnamed: C50.2, R50.2, U5.2 (MCLK)
unnamed: C48.2, R52.2, U5.7 (SCLK)
unnamed: C42.2, C43.2, R41.1, U5.16 (AVDD)
unnamed: C40.2, C41.2, R42.1, U5.6 (DVDD)
unnamed: C38.2, C39.2, R43.1, U5.5 (PVDD)
unnamed: C36.2, C37.2, R44.1, U5.13 (SPKVDD)
unnamed: R23.2, R24.1, R28.2, U6.3 (+)
unnamed: R26.1, U6.2 (-)
unnamed: R22.1, R30.2, U6.5 (+)
unnamed: R27.1, U6.6 (-)
unnamed: C33.1, C57.2, R57.1, U7.3 (VI)
RX: R28.1, R29.1, U6.1; also elsewhere on the board
RX_ANA: R10.1, R12.1, R26.2, U2.4; also elsewhere on the board
TX: R34.2; also elsewhere on the board
TX_EN: R13.2; also elsewhere on the board

Notes on the sheet:
Sine (filtered PWM) out
Make TX turn on/off, so that during non-transmission the Gira Bus is not loaded by the 47nF
Vhigh: 1.63V Vlow: 1.33V
Bandpass Sallenkey with 60kHz from Ti Tool and changed to have higher input impedance. Also added mid points to allow single supply
Additional BoM items:
Silkscreen Symbols:
Power
ESP32mini has Schottky on its 5V output
Filter "bad" ESP clone boards power supply to avoid brownout
Receive
PWM IN
Diode bridge, so that bus polarity does not matter
Main supply is 5V from either USB or 5V input. 3.3V is from ESP, powered by the 5V.
Alternative 5V input
ON/OFF and Buffer Stage
Changelog: v3.1: First release v3.1-1: Change bus connector due to availability v4.0: Audio Support, DC measurement capability v4.1: Adapt to ESP32-S3 board
Conversion Factor: 0,109 (26V = 2,83V ESP voltage)
Bus
Send
ESP32 S3 Dev Board
Power: Power is coming from either the USB connector of the ESP32mini or the not populated 5V input jack. The GDOOR adapter also needs 3.3V, which are generated by the ESP32mini onboard LDO. Warning: the 5V power input jack is not protected against wrong polarity or overvoltage!
CPU: To operate the GDOOR hardware adapter an ESP32mini development board is needed.
Documentation: For more information check out our Github Repo: https://github.com/gdoor-org/gdoor
Signals: RX_ANA: Filtered Bus signal, 60kHz sine signals forming 1 and 0 bits. Analog signal, 0V to 3.3V with offset at 1.65V. RX: Digitized RX_ANA signal, digital 60kHz with fixed digitizing threshold. CMOS3.3V compatible. RX_DAC: Removed in version 4. Digitized RX_ANA signal, digital 60kHz with c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

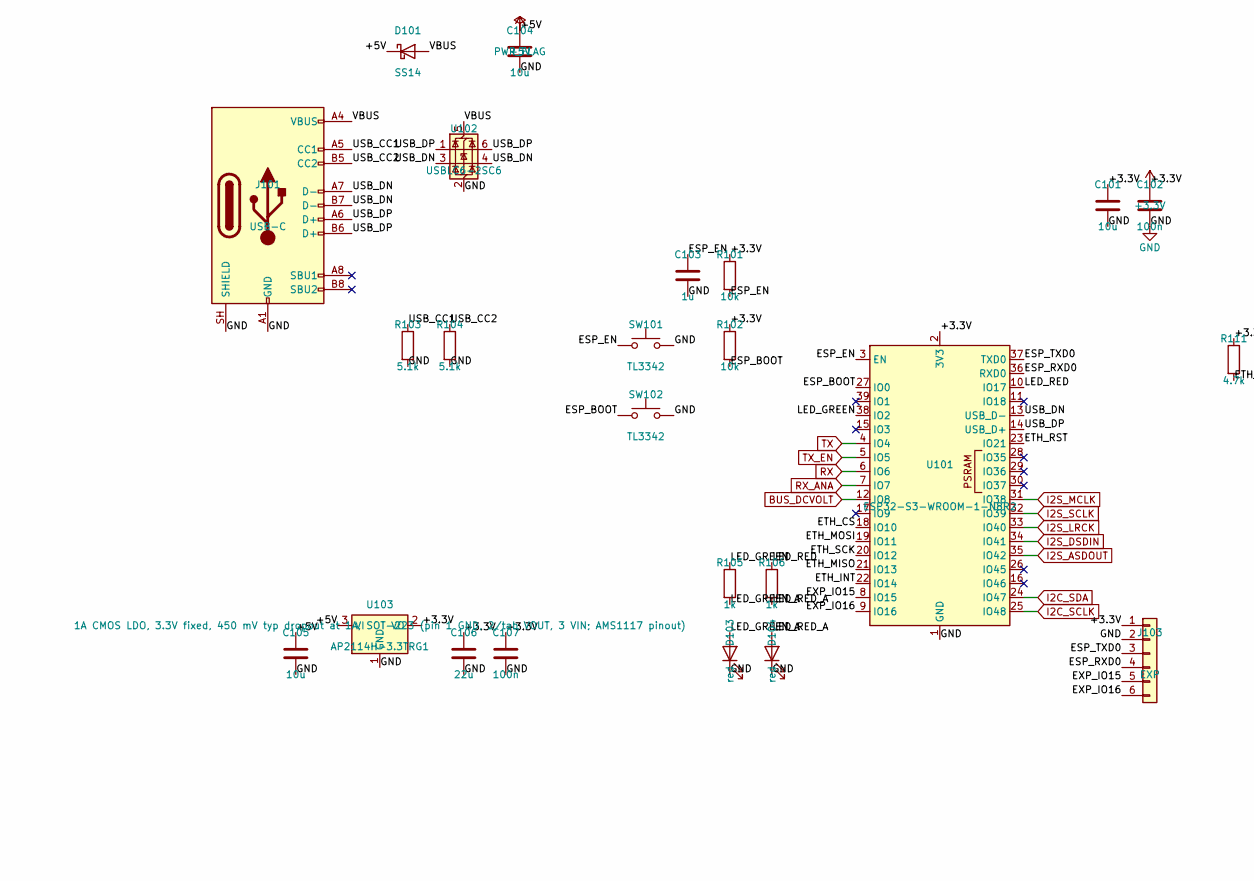
[picture p23: schematic mcu_eth.kicad_sch, part in row 1, column 1]

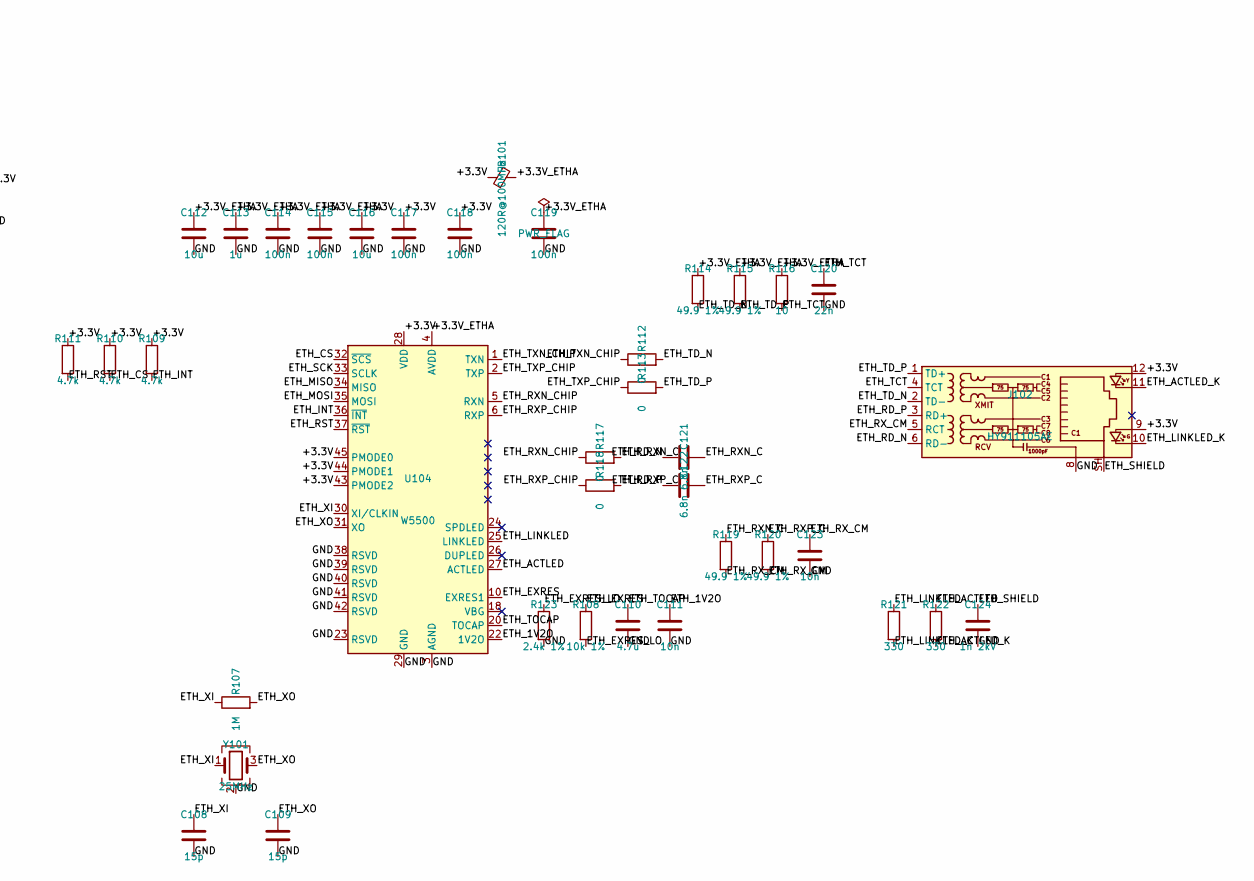
[picture p24: schematic mcu_eth.kicad_sch, part in row 1, column 2]

Parts:
C101, C104, C105, C112, C116: 10u; C_0603_1608Metric; LCSC C19702
C102, C107, C114, C115, C117, C118, C119: 100n; C_0402_1005Metric; LCSC C1525
C103, C113: 1u; C_0402_1005Metric; LCSC C52923
C106: 22u; C_0805_2012Metric; LCSC C45783
C108, C109: 15p; C_0402_1005Metric; LCSC C1548
C110: 4.7u; C_0603_1608Metric; LCSC C19666
C111, C123: 10n; C_0402_1005Metric; LCSC C15195
C120: 22n; C_0402_1005Metric; LCSC C1532
C121, C122: 6.8n; C_0402_1005Metric; LCSC C1542
C124: 1n 2kV; C_1206_3216Metric; LCSC C9196
D101: SS14; D_SMA; LCSC C2480
D103, D104: red; LED_0603_1608Metric; LCSC C2286
FB101: 120R@100MHz; L_0603_1608Metric; LCSC C14709
J101: USB-C; USB_C_Receptacle_HRO_TYPE-C-31-M-12; LCSC C165948
J102: HY911105AE; RJ45_Hanrun_HR911105A_Horizontal; LCSC C69427
J103: EXP; PinHeader_1x06_P2.54mm_Vertical; LCSC C37208
R101, R102: 10k; R_0402_1005Metric; LCSC C25744
R103, R104: 5.1k; R_0402_1005Metric; LCSC C25905
R105, R106: 1k; R_0402_1005Metric; LCSC C11702
R107: 1M; R_0402_1005Metric; LCSC C26083
R108: 10k 1%; R_0402_1005Metric; LCSC C25744
R109, R110, R111: 4.7k; R_0402_1005Metric; LCSC C25900
R112, R113, R117, R118: 0; R_0402_1005Metric; LCSC C17168
R114, R115, R119, R120: 49.9 1%; R_0402_1005Metric; LCSC C25120
R116: 10; R_0402_1005Metric; LCSC C25077
R121, R122: 330; R_0402_1005Metric; LCSC C25104
R123: 2.4k 1%; R_0402_1005Metric; LCSC C25882
SW101, SW102: TL3342; SW_SPST_TL3342; LCSC C318884
U101: ESP32-S3-WROOM-1-N8R2; ESP32-S3-WROOM-1; LCSC C2913204
U102: USBLC6-2SC6; SOT-23-6; LCSC C2687116
U103: AP2114H-3.3TRG1; SOT-223-3_TabPin2; LCSC C150716
U104: W5500; LQFP-48_7x7mm_P0.5mm; LCSC C32843
Y101: 25MHz; Crystal_SMD_3225-4Pin_3.2x2.5mm; LCSC C9006

Connections:
+3.3V: C101.1, C102.1, C106.1, C107.1, C116.1, C117.1, C118.1, FB101.1, J102.9, J102.12, J103.1, R101.1, R102.1, R109.1, R110.1, R111.1, U101.2 (3V3), U103.2 (VO), U104.28 (VDD), U104.43 (PMODE2), U104.44 (PMODE1), U104.45 (PMODE0); also elsewhere on the board
+5V: C104.1, C105.1, D101.1 (K), U103.3 (VI); also elsewhere on the board
/MCU, USB, Power, Ethernet/+3.3V_ETHA: C112.1, C113.1, C114.1, C115.1, C119.1, FB101.2, R114.1, R115.1, R116.1, U104.4 (AVDD), U104.8 (AVDD), U104.11 (AVDD), U104.15 (AVDD), U104.17 (AVDD), U104.21 (AVDD)
/MCU, USB, Power, Ethernet/ESP_BOOT: R102.2, SW102.1, U101.27 (IO0)
/MCU, USB, Power, Ethernet/ESP_EN: C103.1, R101.2, SW101.1, U101.3 (EN)
/MCU, USB, Power, Ethernet/ESP_RXD0: J103.4, U101.36 (RXD0)
/MCU, USB, Power, Ethernet/ESP_TXD0: J103.3, U101.37 (TXD0)
/MCU, USB, Power, Ethernet/ETH_1V2O: C111.1, U104.22 (1V2O)
/MCU, USB, Power, Ethernet/ETH_ACTLED: R122.1, U104.27 (ACTLED)
/MCU, USB, Power, Ethernet/ETH_ACTLED_K: J102.11, R122.2
/MCU, USB, Power, Ethernet/ETH_CS: R110.2, U101.18 (IO10), U104.32 (~SCS)
/MCU, USB, Power, Ethernet/ETH_EXRES: R108.1, U104.10 (EXRES1)
/MCU, USB, Power, Ethernet/ETH_EXRES_LO: R108.2, R123.1
/MCU, USB, Power, Ethernet/ETH_INT: R109.2, U101.22 (IO14), U104.36 (~INT)
/MCU, USB, Power, Ethernet/ETH_LINKLED: R121.1, U104.25 (LINKLED)
/MCU, USB, Power, Ethernet/ETH_LINKLED_K: J102.10, R121.2
/MCU, USB, Power, Ethernet/ETH_MISO: U101.21 (IO13), U104.34 (MISO)
/MCU, USB, Power, Ethernet/ETH_MOSI: U101.19 (IO11), U104.35 (MOSI)
/MCU, USB, Power, Ethernet/ETH_RD_N: C121.1, J102.6 (RD-)
/MCU, USB, Power, Ethernet/ETH_RD_P: C122.1, J102.3 (RD+)
/MCU, USB, Power, Ethernet/ETH_RST: R111.2, U101.23 (IO21), U104.37 (~RST)
/MCU, USB, Power, Ethernet/ETH_RXN_C: C121.2, R117.2, R119.1
/MCU, USB, Power, Ethernet/ETH_RXN_CHIP: R117.1, U104.5 (RXN)
/MCU, USB, Power, Ethernet/ETH_RXP_C: C122.2, R118.2, R120.1
/MCU, USB, Power, Ethernet/ETH_RXP_CHIP: R118.1, U104.6 (RXP)
/MCU, USB, Power, Ethernet/ETH_RX_CM: C123.1, J102.5 (RCT), R119.2, R120.2
/MCU, USB, Power, Ethernet/ETH_SCK: U101.20 (IO12), U104.33 (SCLK)
/MCU, USB, Power, Ethernet/ETH_SHIELD: C124.1, J102.SH
/MCU, USB, Power, Ethernet/ETH_TCT: C120.1, J102.4 (TCT), R116.2
/MCU, USB, Power, Ethernet/ETH_TD_N: J102.2 (TD-), R112.2, R114.2
/MCU, USB, Power, Ethernet/ETH_TD_P: J102.1 (TD+), R113.2, R115.2
/MCU, USB, Power, Ethernet/ETH_TOCAP: C110.1, U104.20 (TOCAP)
/MCU, USB, Power, Ethernet/ETH_TXN_CHIP: R112.1, U104.1 (TXN)
/MCU, USB, Power, Ethernet/ETH_TXP_CHIP: R113.1, U104.2 (TXP)
/MCU, USB, Power, Ethernet/ETH_XI: C108.1, R107.1, U104.30 (XI/CLKIN), Y101.1
/MCU, USB, Power, Ethernet/ETH_XO: C109.1, R107.2, U104.31 (XO), Y101.3
/MCU, USB, Power, Ethernet/EXP_IO15: J103.5, U101.8 (IO15)
/MCU, USB, Power, Ethernet/EXP_IO16: J103.6, U101.9 (IO16)
/MCU, USB, Power, Ethernet/LED_GREEN: R105.1, U101.38 (IO2)
/MCU, USB, Power, Ethernet/LED_GREEN_A: D103.2 (A), R105.2
/MCU, USB, Power, Ethernet/LED_RED: R106.1, U101.10 (IO17)
/MCU, USB, Power, Ethernet/LED_RED_A: D104.2 (A), R106.2
/MCU, USB, Power, Ethernet/USB_CC1: J101.A5 (CC1), R103.1
/MCU, USB, Power, Ethernet/USB_CC2: J101.B5 (CC2), R104.1
/MCU, USB, Power, Ethernet/USB_DN: J101.A7 (D-), J101.B7 (D-), U101.13 (USB_D-), U102.3 (I/O2), U102.4 (I/O2)
/MCU, USB, Power, Ethernet/USB_DP: J101.A6 (D+), J101.B6 (D+), U101.14 (USB_D+), U102.1 (I/O1), U102.6 (I/O1)
/MCU, USB, Power, Ethernet/VBUS: D101.2 (A), J101.A4 (VBUS), J101.A9 (VBUS), J101.B4 (VBUS), J101.B9 (VBUS), U102.5 (VBUS)
BUS_DCVOLT: U101.12 (IO8); also elsewhere on the board
GND: C101.2, C102.2, C103.2, C104.2, C105.2, C106.2, C107.2, C108.2, C109.2, C110.2, C111.2, C112.2, C113.2, C114.2, C115.2, C116.2, C117.2, C118.2, C119.2, C120.2, C123.2, C124.2, D103.1 (K), D104.1 (K), J101.A1 (GND), J101.A12 (GND), J101.B1 (GND), J101.B12 (GND), J101.SH (SHIELD), J102.8, J103.2, R103.2, R104.2, R123.2, SW101.2, SW102.2, U101.1 (GND), U101.40 (GND), U101.41 (GND), U102.2 (GND), U103.1 (GND), U104.3 (AGND), U104.9 (AGND), U104.14 (AGND), U104.16 (AGND), U104.19 (AGND), U104.23 (RSVD), U104.29 (GND), U104.38 (RSVD), U104.39 (RSVD), U104.40 (RSVD), U104.41 (RSVD), U104.42 (RSVD), U104.48 (AGND), Y101.2 (G), Y101.4 (G); also elsewhere on the board
I2C_SCLK: U101.25 (IO48); also elsewhere on the board
I2C_SDA: U101.24 (IO47); also elsewhere on the board
I2S_ASDOUT: U101.35 (IO42); also elsewhere on the board
I2S_DSDIN: U101.34 (IO41); also elsewhere on the board
I2S_LRCK: U101.33 (IO40); also elsewhere on the board
I2S_MCLK: U101.31 (IO38); also elsewhere on the board
I2S_SCLK: U101.32 (IO39); also elsewhere on the board
RX: U101.6 (IO6); also elsewhere on the board
RX_ANA: U101.7 (IO7); also elsewhere on the board
TX: U101.4 (IO4); also elsewhere on the board
TX_EN: U101.5 (IO5); also elsewhere on the board

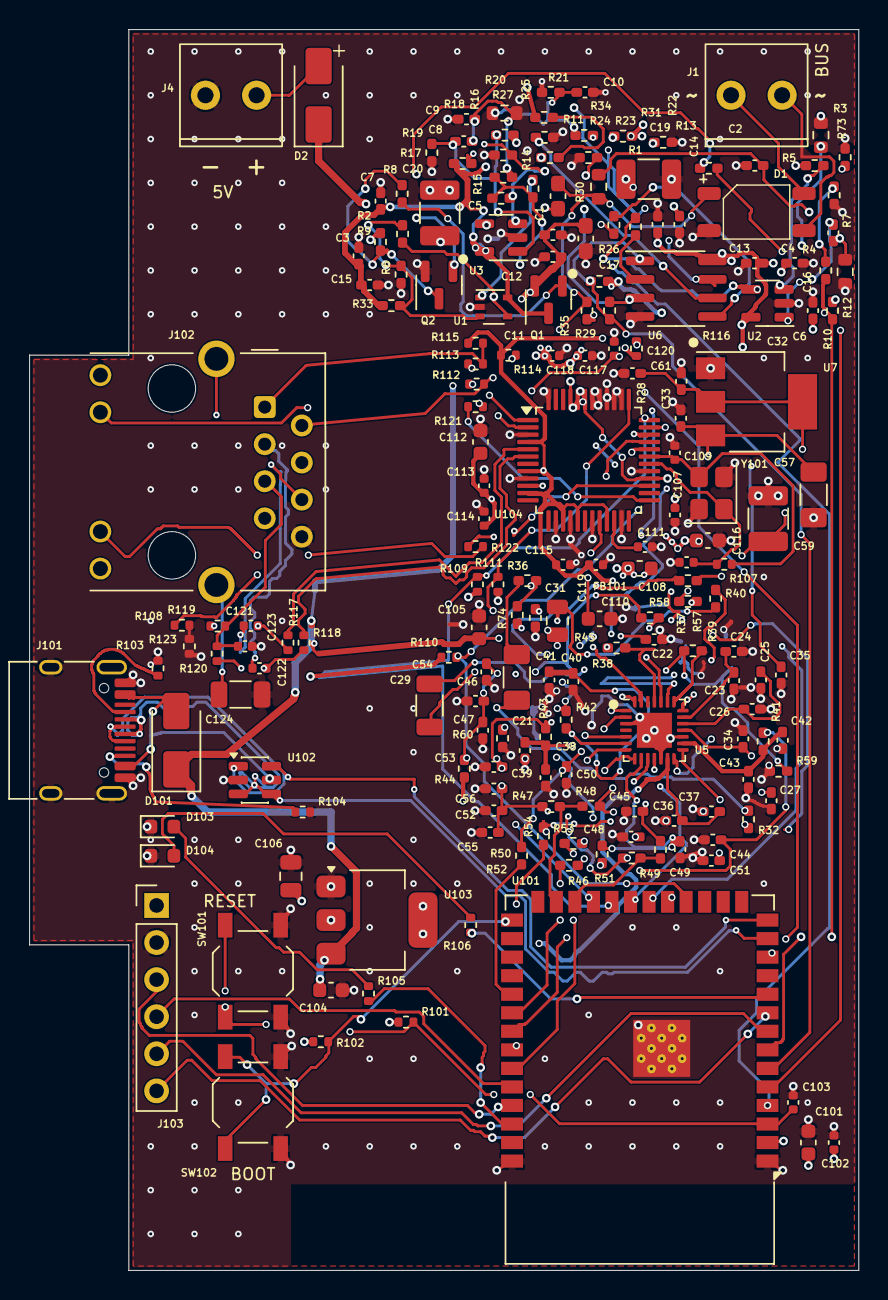
[picture p25: board esp32.kicad_pcb from above]

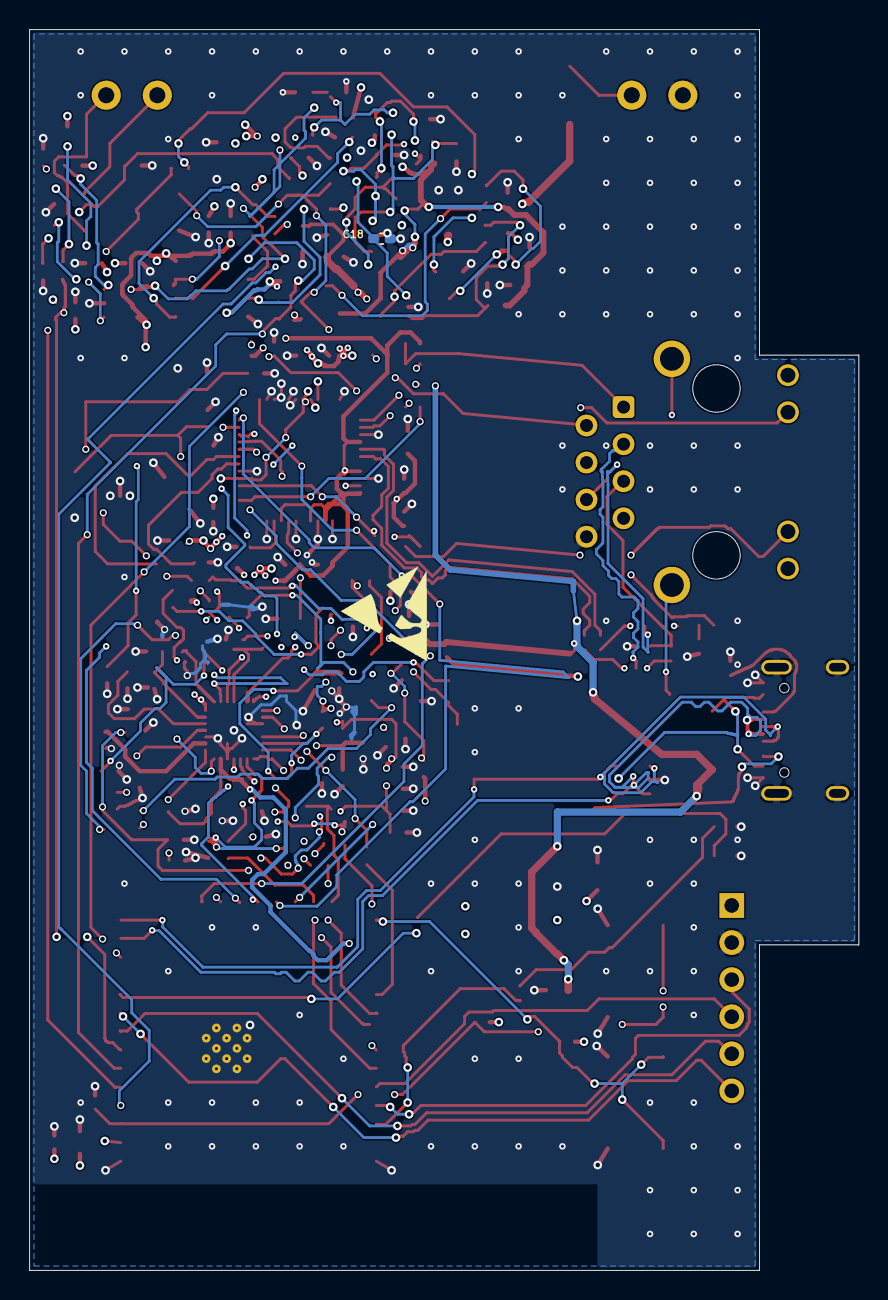
[picture p26: board esp32.kicad_pcb from below]

Board: 4 copper layers, 56.8 x 85.0 mm, 191 parts (2 on the bottom side), 116 nets.
