Pytonballoon810/gdoor/(commit log)

2026-10-16 Fix firmware build: replace removed Jason2866 Arduino/IDF5 platform with pinned pioarduino 55.03.311
    The Arduino/IDF5 branch no longer exists upstream, so pio run (and the CI job)
    fails before compiling. pioarduino is the maintained successor; pinning a
    release keeps the timer/LEDC API stable.
2026-10-16 Firmware: confirm sent bus messages, publish status, recover from WiFi/MQTT drops
    - Remove the empty UDP_TRANSMITTER stub from the audio branch: it was declared
    but never defined, so the merged firmware did not link. The audio firmware
    (ESP-ADF on ESP32-S3) lives outside this repository.
    - #48: once a message from MQTT/serial has been put on the bus, publish it on
    the bus_rx topic with "origin": "GDOOR_TX", followed by the usual idle
    message. Can be disabled in the web config ("Publish sent bus messages").
    - #50: publish a status JSON every 60 s to <bus_rx>/status (version, IP, SSID,
    BSSID, RSSI, uptime, free heap, reset reason, WiFi disconnects, MQTT
    connects, bus rx/tx counters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
    [defines.h, gdoor.cpp, gdoor.h, gdoor_data.cpp, gdoor_data.h, gdoor_tx.cpp, gdoor_tx.h, main.cpp]
2026-10-16 Add ESPHome external component (#25)
    esphome/components/gdoor wraps the firmware's bus core for ESPHome:
    - gdoor: hub with configurable rx/tx/tx-enable pins, optional DAC threshold
    pin and sensitivity, on_message/on_sent automations
    - event platform, filterable by action, parameters, source, destination or
    busdata; event types are the bus actions, e.g. a doorbell event for
    BUTTON_RING of one specific button
    - button platform sending a fixed message, gdoor.send action (queued until
    the bus is idle)
    - text_sensor platform with the last action, busdata or JSON
    - every valid message is logged with its busdata, so codes for buttons and
    filters can be copied from the ESPHome log
    ESPHome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
    [button.py, defines.h, event.py, gdoor.cpp, gdoor.h, gdoor_component.cpp, gdoor_component.h]
2026-10-16 Firmware: optional W5500 Ethernet module (#47)
    A W5500 SPI module can be wired to the free VSPI pins of an existing adapter
    (SCK 18, MISO 19, MOSI 23, CS 5, INT 4, RST 16; v3.x uses GPIO 21/22/25/26/27,
    checked against the v3.1 schematic) and enabled in the web config.
    - Ethernet becomes the default route once it has an IP, WiFi stays as fallback
    - MQTT connects when either interface is up and reconnects when an interface
    comes up, so the connection moves to Ethernet
    - the WiFi watchdog does not restart the adapter while Ethernet is up
    - status JSON reports the active interface ("network") and its IP; HA
    discovery's configuration_url uses that IP as well
    - a missing module only logs a m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
    [defines.h, mqtt_helper.cpp, wifi_helper.cpp, wifi_helper.h]
2026-10-16 Firmware: web console (#45) and larger app partitions
    Web console at /console ("Console" in the menu), served by WiFiManager's web
    server: live log of bus messages (same JSON as MQTT) and WiFi/Ethernet/MQTT
    events, the status JSON, and a field to send bus data. The log is a 60 line
    RAM ring buffer, nothing is written to flash.
    Sending from the console is opt-in ("Web console can send to the bus"), as
    the web interface has no password. POSTs need an X-GDoor-Console header, which
    other origins can not send without a CORS preflight that is never answered.
    Partition table switched to min_spiffs.csv (2x 1.875 MB app, 128 kB LittleFS):
    with Ethernet the firmware was at 94.9% of the old 1.25 MB s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
2026-10-16 Firmware: adapter hardware setting for v4.0 (TX on IO12, no threshold DAC)
    The v4.0 audio prototype routes IO25/IO26 to the audio codec (I2S) and moves
    bus TX to IO12. New "Adapter hardware" setting in the web config:
    - v3.x (default): unchanged, TX IO25, RX per "RX Input", DAC threshold IO26
    - v4.0: TX IO12, RX IO21 (fixed threshold; IO22 is not connected, R56 not
    fitted), no DAC write, so the codec lines are not driven
    IO12 is the flash-voltage strapping pin; checked in the v4.0 schematic that it
    reads low at boot: R21 (4k7) is not fitted and the transmit filter (U3) is on
    +5Vonoff, which Q1/Q2 only switch on with TX_EN.
    Ethernet is refused on v4.0, as the W5500 pins (IO5, IO18, IO23)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
    [defines.h, main.cpp, wifi_helper.cpp, wifi_helper.h]
2026-10-16 Add design spec for a DIN-rail GDoor board with Ethernet and audio
    2-module DIN enclosure, ESP32-S3-WROOM-1-N8R2 on board, W5500 Ethernet, ES8374
    audio and the v4.0 bus interface, 5 V via USB-C or terminal. Includes the S3
    pin map and checked JLCPCB parts. Spec only, no schematic or layout yet.
2026-10-16 DIN board: schematic for ESP32-S3, USB-C, power and W5500 Ethernet
    hardware/gdoor-din starts from the v4.1 bus/audio schematic with the unwired
    ESP32-S3 devkit header symbols removed, and adds a sub-sheet mcu_eth with:
    - ESP32-S3-WROOM-1-N8R2, EN/BOOT buttons, two status LEDs (issue #46)
    - USB-C (TYPE-C-31-M-12) with CC pull-downs, USBLC6-2SC6 ESD, SS14 to +5V
    - AMS1117-3.3 for the digital 3.3 V rail (previously supplied by the D1 mini)
    - W5500 + HR911105A per WIZnet's WIZ850io reference (12.4k EXRES, 25 MHz
    crystal, TX/RX termination, ferrite-isolated analog supply)
    - expansion/serial header (IO15, IO16, TXD0, RXD0)
    Bus and audio signals connect via global labels (pin map in DESIGN.md);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
    [User Library-WJ127-5_0-2P.step, esp32.kicad_sch, mcu_eth.kicad_sch, screwterminal.stp, screwterminal_3_5mm_2.STEP]
2026-10-16 DIN board: clean up main sheet, fit 5 V input terminal
    After re-saving in KiCad (which refreshed 52 stale cached references from an
    older copied-in project), remove the leftover ESP32-S3 devkit symbol, its
    orphaned power symbols, dangling wire stubs and bus entries, and convert the
    bus/audio signal labels to global labels so they connect to the MCU sheet.
    J4 (5 V screw terminal via D2) now uses the 3.5 mm terminal C695629 like J1.
    ERC: 0 errors on both sheets; remaining warnings are the original drawing's
    off-grid endpoints and the unused RX_DAC label (R56 not fitted).
    Still to do in KiCad: untick DNP / tick 'in BOM' on J4.
    [esp32.kicad_sch, mcu_eth.kicad_sch]
2026-10-16 DIN board: 0402 passives, placement, planes, partial routing
    Copied bus/audio sheet: 100 resistors and caps from 0603 to 0402 (JLC parts
    updated); C1, C28-C31 (bus voltage) and C12 (10u on +5V) stay 0603.
    Board: all 208 parts placed by block (bus top, W5500 behind RJ45, codec,
    power/USB front), DNP options on the back. 4 layers: In1 GND, In2 +3.3V,
    175 plane vias. Autorouted with KiCadRoutingTools; 34 connections still
    open around the W5500 and the ES8374. DRC: 0 errors.
    [esp32.kicad_pcb, esp32.kicad_sch]
2026-10-16 DIN board: routing down to 5 open connections, DRC clean
    Codec escape ring widened to 2.2 mm (15 passives moved), every U5 pin
    has a straight escape stub, U5 GND pins tie inward to the exposed pad.
    Remaining routing done with a scripted grid router (exact clearances,
    rip-up); 5 connections around the W5500 crystal and the ES8374 are
    still open, and several of those routes meander and need a clean-up.
    esp32.kicad_dru: "PTH to Track" (0.33 mm) and "Pad to Track" (0.2 mm)
    now apply to pads only. As written they also caught every via and
    overrode the file's own 0.254 mm via rule (JLCPCB's via limit).
    [esp32.kicad_pcb]
2026-10-17 gdoor-din: finish routing, 0.45/0.2 mm vias, drop unused mic options
    - Route every net: kicad-cli DRC reports 0 unconnected, 0 errors,
    schematic parity clean.
    - Project rules: min via 0.45 mm / drill 0.2 mm (JLCPCB standard on
    4 layers), Default netclass track 0.2 mm, via 0.45/0.2.
    - Schematic: remove the option parts C28, C30, R61-R66, R67/R68 and
    their dangling wiring; keep R69-R72 (attenuation) and C62/C63
    (filtering). No-connects on the unused U5 speaker pins.
    Open: one 0.07 mm +3.3V dangling stub, silk clean-up, F/B GND pours.
    [esp32.kicad_pcb, esp32.kicad_sch]
2026-10-17 gdoor-din: GND pours, stitching, antenna plane keepout, silk clean-up
    - Remove the dangling +3.3V stub chain (7 items named by kicad-cli DRC).
    - GND pours on F.Cu and B.Cu (0.2 mm clearance, thermal reliefs,
    islands removed) and 134 GND stitching vias at 0.45/0.2 on a 3 mm
    grid, placed only where they clear every other net.
    - Rule area on In1/In2 under the ESP32-S3 antenna (the module's own
    keepout only covered F/B), so the inner planes no longer run under it.
    - Reference text at 0.8 / 0.12 (Nobble convention), each placed clear of
    pads, silk and the edge; 158 visible, 39 in the densest 0402 clusters
    hidden (still on F.Fab). U101 antenna-end silk pulled inside the edge.
    - DRU "Mini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
    [esp32.kicad_pcb]
2026-10-17 gdoor-din: document layout, rules, removed parts and fab files
    DESIGN.md: status is now routed and DRC-clean. New Layout section covers
    the GND pours, stitching vias and antenna plane keepout, the 0.45/0.2 via
    rule, the 0.8/0.12 silk rule with 39 hidden references, and the removed
    mic option parts (C28, C30, R61-R68). New Manufacturing section says how
    the JLCPCB files in gdoor-fab/din were made. New open points: J4 is DNP,
    J103 has no LCSC number, some decaps are far from their pins.
2026-10-17 gdoor-din: 1210 part for the 100u caps, unify resistor values for JLC BOM
    JLCPCB flagged two BOM problems:
    - C19, C20, C59 sit on 1210 pads but carried C15008, a 1206 6.3 V part
    (CL31A107MQHNNNE; same mismatch upstream). Now C23742
    (CL32A107MPVNNNE, 100 uF 10 V X5R 1210), which also gives C20 on +5V
    a sensible voltage margin.
    - One part matched several BOM lines because the copied sheet spelled
    values "5k1"/"4k7" and the new sheet "5.1k"/"4.7k". R5, R7, R16, R17
    are now 5.1k and R26 4.7k.
    The copied sheet's symbols carry stale Reference properties from the
    upstream sheet, so Konnect edited the wrong symbols; the edit was keyed
    on each symbol's live instance instead and the file re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
    [esp32.kicad_pcb, esp32.kicad_sch]
2026-10-17 gdoor-din: fab files regenerated from 765459f
    DESIGN.md now names 765459f as the source of gdoor-fab/din, which carries
    C23742 for the 1210 100u caps and the unified 5.1k/4.7k resistor values.
2026-10-17 gdoor-din: give SW101/SW102 one value so JLC merges their BOM line
    Both buttons are the same part (C318884); the values RESET and BOOT
    made two BOM lines matched to one part, which JLC flags. Both are now
    "TL3342"; the schematic net labels still say which is which.
    [esp32.kicad_pcb, mcu_eth.kicad_sch]
2026-10-17 gdoor-din: jlcfab.py builds the JLCPCB files, with three JLC fixes
    The fab pipeline was a set of scratch scripts; it is now one script in
    the repo that runs the Fabrication Toolkit on a temp copy of the board.
    Fixes from JLC's upload preview:
    - J101 (USB-C, C165948) gets FT Position Offset 0,1.39 so its CPL point
    matches JLC's model on the peg holes: 105.54/-108.0 instead of 104.15.
    - BOM columns rewritten to JLC's template (Comment, Designator,
    Footprint, LCSC Part #); "Value" made the PCBA quote fail.
    - J103 (hand-soldered header, no LCSC part) left out of BOM and CPL.
    The script also disables wx asserts/logging and plugin registration before
    any import (no popups), waits for the toolk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
2026-10-17 gdoor-din: route Ethernet RX and USB D+/D- as coupled, length-matched pairs
    Both pairs were routed as two independent nets (USB 3.3 mm and the
    Ethernet receive chain ~2-4 mm apart, with the RX legs on different
    layers and up to 11 vias). Now:
    - RX passives re-placed as a mirrored cluster so no leg has to cross
    the other on one layer: R117/R118 stand side by side with their chip
    pads at the top; C121<->C122 and R119<->R120 swapped so P and N each
    stay on their own side. C124 (shield cap) moved out of the way.
    - Pairs routed coupled at 0.2 mm / 0.15 mm gap (~100 ohm differential
    over the In1 GND plane): RX chip side on F.Cu, RX jack side and both
    USB segments on B.Cu, with 45-degree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
    [esp32.kicad_pcb]
2026-10-17 gdoor-din: keep the JLCPCB production files in the repo
    Moved from Documents/Claude/gdoor-fab/din into production/gdoor_din/,
    following the hardware/esp32/production/<name>/ convention. Built from
    0a8af0d by jlcfab.py; DESIGN.md now points there.
    [bom.csv, designators.csv, positions.csv]
2026-10-17 production: JLCPCB files for v3.1-1 and v4.0 boards from this branch
    Gerbers, BOM (plus priced BOM), CPL and IPC netlist built with bennymeg's
    Fabrication Toolkit CLI from this branch's boards, previously kept outside
    the repo in Documents/Claude/gdoor-fab. Placed in jlcpcb/ next to
    upstream's own esp32.zip/netlist.ipc so those stay untouched.
2026-10-17 gdoor-din: interactive BOM with Part-DB storage and JLC cost
    partdb_ibom.py runs nobble's partdb_bom.py (imported, not copied) on the
    JLC BOM: Comment is mapped to Value, and tolerances and ratings
    (12.4k 1%, 1n 2kV, 120R@100MHz) are normalised for matching only.
    Every LCSC number is priced from JLCPCB's parts library. The resulting
    ibom-partdb.html has nobble's storage column and Sourced ticks, plus a
    cost panel: JLC cost per line for N boards, the $3 extended fee,
    ownership, and a HAND_SOLDERED list for jlcfab.py from the lines you tick.
    15 of 58 lines are in Part-DB; they come to $11.74 of $135.14 for 5
    boards. $54 of the total is extended-part fees.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
    [bom-partdb.csv]
2026-10-17 gdoor-din: set the board stackup to JLCPCB JLC04161H-7628
    The board file carried KiCad's default 4-layer stackup (3 x 0.48 mm,
    er 4.5). It now matches the JLC 1.6 mm build: 0.2104 mm 7628 prepreg
    (er 4.4) under each outer layer, 1.065 mm core, 0.0152 mm inner copper.
    KiCad's impedance numbers now match the fab: a 2D field solve gives
    65.7 ohm single-ended for 0.2 mm tracks and 98.8 ohm differential for
    the 0.2/0.15 mm USB and Ethernet RD pairs. DRC with schematic parity
    is unchanged: no errors, only the cosmetic U101 library-mismatch
    warning.
    [esp32.kicad_pcb]
2026-10-17 gdoor-din: AP2114H regulator, front tab with flush RJ45 and USB-C
    U103 (3.3 V digital) is now an AP2114H-3.3TRG1 (LCSC C150716): 1 A,
    450 mV typ / 750 mV max dropout at 1 A, against about 1.1 V for the
    AMS1117, so WiFi TX bursts do not brown out the S3. Same pinout as the
    AMS1117 (1 GND, 2/tab VOUT, 3 VIN); the AP2114HA has a different one.
    C104/C106 already meet the 4.7 uF minimum. JLC extended part.
    The board gets a 6.8 x 40.4 mm front tab in the DIN window. J101 and
    J102 move 8.45 mm forward (J102 also 0.8 mm down) with their Ethernet
    and USB parts; their faces end 0.2 mm inside the window face. Tracks
    crossing the moved block keep their shape and get connectors along the
    move, so both h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
    [board_ghost.scad, bom-partdb.csv, bom.csv, enclosure.scad, esp32.kicad_pcb, gdoor-din-base.stl, gdoor-din-lid.stl, mcu_eth.kicad_sch]
2026-10-17 gdoor-din: logic check, drop unused options, flush USB-C cut-out
    Logic check of the schematic against the netlist (ERC, block by block).
    One real error: the BOOT/RESET labels were swapped. SW101 is EN (RESET),
    SW102 is IO0 (BOOT). Fixed on the silkscreen and on the enclosure lid.
    Removed the unfitted options that have no use on this board: R55
    (+3.3V to +3.3V_AUDIO link), R56 (RX_DAC link), R69-R72 (mic
    attenuation) and C62/C63 (alternative mic coupling), with their wiring
    and their tracks (including a +3.3V_AUDIO run on In2.Cu that only served
    R55). Netlist comparison: no remaining pin changed net. DRC: 0 errors,
    0 unconnected. BOM and CPL unchanged (all were DNP).
    Silkscreen labels RESET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
    [designators.csv, enclosure.scad, esp32.kicad_pcb, esp32.kicad_sch, gdoor-din-base.stl, gdoor-din-lid.stl]
2026-10-18 gdoor-din: 50 V bus caps, fit C10/R21 on the front
    C29 and C31 sit on the bus DC (up to about 30 V) through R74 and were
    25 V parts. C29 is now 10 uF 50 V 1206 (C13585, like C21); C31 is
    10 uF 50 V 0805 (C440198), since a 1206 does not fit at its spot. C31's
    pad-1 route to R40 is re-routed down its right side.
    C10 (1 nF) and R21 (4k7) on the TX node are fitted on the upstream
    board but were DNP on B.Cu here. They are now on F.Cu, fitted by JLC,
    joined to the old TX-node track by a via, with their own GND vias.
    C18 (100 pF, TX driver input) has no free F.Cu spot and stays on B.Cu
    for hand soldering.
    Schematic: C10/R21 no longer DNP, the leftover RX_DAC bus entry is
    removed; ERC has no error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
    [bom-partdb.csv, bom.csv, esp32.kicad_pcb, esp32.kicad_sch, positions.csv]
2026-10-18 Reorganise repo: firmware/, hardware/{boards,lib,releases}, shared KiCad library
    [ESP32-S3-DEVKITC-1-N8R2.step, User Library-WJ127-5_0-2P.step, board_ghost.scad, bom-partdb.csv, bom.csv, designators.csv, enclosure.scad, esp32-wemos-d1-mini.step]
2026-10-18 gdoor-din: refill stale zones, regenerate JLCPCB files
    The C10/R21 and C29/C31 changes were saved without a zone refill, so
    the gerbers poured GND over C10, R21 and C29 on F.Cu, put the TX-node
    via in GND and +3.3V, and put two GND vias in the In2 +3.3V plane.
    Refill and save the board, and have jlcfab.py pass -f so the toolkit
    refills zones before every export. DRC: 0 errors, 0 parity issues.
    [esp32.kicad_pcb]
2026-10-18 gdoor-din: fix JLC CPL rotations/offsets, merge BOM duplicates, add 3D models
    CPL: Library:SOT-23 and SOT-23-5 are drawn 180 deg from KiCad's standard
    footprints, so the toolkit's database turned Q1/Q2/U2/U3 upside down.
    jlcfab.py now takes fixed rotations for those, D1, U102 and J1, and
    position offsets for U101 (3.6 mm), U7 and U103. All values come from
    fitting JLC's EasyEDA footprints onto the board pads; the run checks them.
    BOM: lines sharing an LCSC part are merged (R21 "4k7" vs "4.7k" made JLC
    report two lines matched to C25900).
    3D: JLC/LCSC STEP models for U5 (ES8374), J101 (HRO USB-C), J102 (Hanrun
    RJ45) and D1 (MB10S), which had missing or non-existent models.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
    [ES8374_QFN-28_4x4mm_P0.45mm.step, MB10S_MBS.step, RJ45_Hanrun_HR911105A.step, USB_C_HRO_TYPE-C-31-M-12.step, bom.csv, esp32.kicad_pcb, positions.csv]
2026-10-18 gdoor-din enclosure: export base and lid as STEP
    OpenSCAD 2021.01 cannot write STEP, so step_export.py sews the STLs into
    closed solids with OpenCascade and merges flat faces. Adds the base, the
    lid (print orientation) and the assembled enclosure.
    [gdoor-din-base.step, gdoor-din-enclosure.step, gdoor-din-lid.step]
2026-10-18 gdoor-din: cut JLC Extended-part fees from $60 to $21
    Hand-soldered and left off the JLC order (jlcfab.py HAND_SOLDERED): J1,
    J102, U103, U102, U2/U3, C19/C20/C59, Y101.
    No-fee parts instead of Extended ones (schematic, board fields, DESIGN.md):
    - 18k, 2.4k, 6.8 nF: same values as Preferred parts C25762/C25882/C1542
    - 82k -> 100k Basic C25741: R3/R4 and R18/R19 are 1:1 reference dividers;
    R35 makes the bus-voltage divider 100k/10k (/11, about 34 V full scale)
    - R112/R113/R117/R118 3.3 ohm -> 0 ohm: series resistors between the W5500
    and its 49.9 ohm terminations
    - D103 green -> red C2286, R105 100 ohm -> 1k so both LEDs run ~1.3 mA
    Still Extended: U1, U5, U101, U104, J101, R1/R20 (130k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
    [bom.csv, esp32.kicad_pcb, esp32.kicad_sch, mcu_eth.kicad_sch, positions.csv]
2026-10-19 gdoor-din: crystal back to JLC, ESP32 module hand-soldered
    Y101 goes back on the JLC order: its pads are under the crystal and it
    needs accurate placement. U101 (ESP32-S3-WROOM-1) cannot be placed in
    JLC's Economic PCBA, so it joins HAND_SOLDERED; DESIGN.md notes that its
    centre GND pad needs hot air or a hot plate.
    [bom.csv, positions.csv]
2026-10-20 gdoor core: bus timing on ESP-IDF drivers, no Arduino types
    Phase 1 of esphome/VOICE_PLAN.md. The shared bus core no longer uses the
    Arduino timer, LEDC, DAC or String APIs, so it builds on plain ESP-IDF
    (ESPHome) as well as on Arduino-ESP32 3.x (MQTT firmware).
    - TX: LEDC 52 kHz, 10 bit, duty 512, gated by ledc_update_duty/ledc_stop
    from a 60 kHz gptimer alarm that keeps the pulse-count state machine.
    - RX: GPIO falling-edge ISR plus one free-running 120 kHz gptimer whose
    alarm moves from "bit end" (last edge + 20) to "bitstream end"
    (last edge + 6*STARTBIT_MIN_LEN); no timer stop/start from ISRs.
    RX is disabled during TX by a flag instead of detaching the interrupt.
    - ISRs and hel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
    [defines.h, gdoor.cpp, gdoor.h, gdoor_component.cpp, gdoor_data.h, gdoor_rx.cpp, gdoor_rx.h, gdoor_tx.cpp]
2026-10-21 ESPHome: ESP-IDF support, DIN board configs, voice via VoIP Stack
    Phases 2-4 and 6 of esphome/VOICE_PLAN.md (configuration only, not tested
    on hardware).
    Component:
    - No longer Arduino-only; the bus core now uses ESP-IDF drivers.
    - rx_threshold_pin is validated per chip (DAC pins of ESP32/ESP32-S2,
    rejected on the S3) and pulls the DAC driver into the build.
    - Sets the gptimer/GPIO/LEDC IRAM options so the bus ISRs keep running
    during flash writes; dump_config reports it.
    Configs:
    - gdoor-example.yaml switches to esp-idf.
    - gdoor-din-ethernet.yaml / gdoor-din-wifi.yaml for the DIN board (S3 N8R2,
    W5500, bus voltage and "bus connected" from GPIO8, LEDs on GPIO2/17),
    sharing din/comm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
    [common.yaml, gdoor_component.cpp]
2026-10-21 gdoor-din: R3/R4 back to 82k, RX band-pass oscillated with 100k
    R3/R4 are the ground leg of the RX Sallen-Key band-pass (U2, gain 1.94),
    not only a 1.65 V divider. With 100k (7ce317d) its damping goes negative
    and the stage oscillates at ~49 kHz with no bus signal; it is stable
    below ~90k. Back to 82k (C2909388, Extended, as upstream esp32-mini).
    JLC has no fee-free 82k in 0402. R18/R19 stay 100k: the TX stage
    (gain 1.39) is stable and its peak moves onto the 52 kHz carrier.
    Add spice/: ngspice testbench of the bus side on KiCad's ngspice.dll
    (RX/TX filters, comparator, +5V_onoff switch, codec coupling, hot-plug),
    results and plots in spice/README.md. Production files regenerated
    (BOM chang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
    [bom.csv, esp32.kicad_pcb, esp32.kicad_sch]
2026-10-21 ESPHome: request the gptimer and LEDC drivers explicitly
    ESPHome 2026.10 leaves esp_driver_gptimer and esp_driver_ledc out of the
    build unless a component asks for them, so the example (plain ESP32,
    no other LEDC/timer user) failed with "driver/gptimer.h: No such file".
2026-10-21 gdoor-din: crystal caps 18 pF -> 33 pF, Ethernet front-end simulation
    Y101 (C164045) is rated for CL = 20 pF; C108/C109 at 18 pF gave only
    12-14 pF with stray, pulling the 25 MHz clock +35..+55 ppm (802.3u
    allows +-50 ppm). 33 pF (C1562, JLC Basic) keeps it within +-7 ppm.
    Add spice/eth_sim.py: W5500 + HR911105A front end (magjack fitted to
    typical 10/100 figures). Return loss passes 802.3 on both pairs (~3.5 dB
    margin), ~40 mA TX current gives the nominal 1.0 V MLT-3 level, FB101
    has no resonance problem, C121/C122 put the RX low corner at 220 kHz as
    in WIZnet's reference. plot.py's svg_plot is now importable.
    Production files regenerated (BOM change only; gerbers differ in
    timestamps).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
    [bom.csv, esp32.kicad_pcb, mcu_eth.kicad_sch]
2026-10-22 gdoor-din: J103 gets LCSC C37208
    J103 (1x6 2.54 mm expansion header) was the only part without an LCSC
    number. C37208: BOOMELE 1x6P straight through-hole, gold. It is
    hand-soldered (jlcfab.py HAND_SOLDERED), so the JLC BOM and CPL do not
    change. The board field is hidden on F.Fab like the others.
    [esp32.kicad_pcb, mcu_eth.kicad_sch]
2026-10-22 gdoor-din enclosure: 5 V input plug on top, bus plug on bottom, clip cradles
    - Bus plug moves to the bottom face (x = 42, clear of the lower front
    hold-down post); a new 5 V input plug takes the top position above J4.
    Both cradles come from one `plugs` list, the bottom one mirrored.
    - Each cradle side wall gets a slotted snap finger whose lip catches the
    edge of the plug's screw-side face, so the plugs clip in without glue.
    - Rail latch rebuilt as a spring beam that bends in the print plane.
    - Lid print orientation is a 180 deg rotation, not a mirror; step_export.py
    undoes it accordingly. Button labels moved left of the holes.
    - STLs and STEPs re-exported; fit check empty.
    Co-Author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
    [enclosure.scad, gdoor-din-base.step, gdoor-din-base.stl, gdoor-din-enclosure.step, gdoor-din-lid.step, gdoor-din-lid.stl]
2026-10-22 gdoor-din: four JLC Extended parts made fee-free, values kept
    Saves $12 of JLC's $3-per-type Extended loading fee (8 charged types -> 4).
    - R3/R4 82k: 0402 C2909388 -> 0603 C23254 (Basic).
    - R1/R20 130k: 0402 C2909318 -> 0603 C22795 (Preferred Extended).
    The larger pads needed two small reroutes: Net-(J1-Pin_2) between R3
    and R5, and the Net-(C8-Pad2) diagonal next to R20.
    - R108 12.4k 1% (C2929935) -> R108 10k (C25744) + new R123 2.4k
    (C25882) in series, node ETH_EXRES_LO; 12.4k exactly. R123 sits below
    R108; the GND via beside R108 pad 2 moved to R123 pad 2.
    - Y101 C164045 (CL 20 pF, +-50 ppm) -> C9006 (CL 12 pF, +-20 ppm, Basic),
    same 3225 footprint; C108/C109 33 pF -> 15 pF (C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
    [bom.csv, designators.csv, esp32.kicad_pcb, esp32.kicad_sch, mcu_eth.kicad_sch, positions.csv]
2026-10-22 gdoor-din enclosure: back clips on the plugs, bus plug clear of the buttons
    - The side-wall snap fingers, which gripped the screw-side face, are gone.
    Each plug is now held by two arms behind its wire-entry face, beside
    the wire entries, with hooks over the back edge of the screw-side face.
    They take the push when the cable plug goes on; the old push-in stop
    bar is removed.
    - Bus plug moves from x = 42 to x = 32 so its wires clear the RST and
    BOOT button tubes.
    - STLs and preview rebuilt; fit check empty. STEPs not regenerated
    (no cadquery-ocp here), so they still show the old cradles.
    [enclosure.scad, gdoor-din-base.stl, gdoor-din-lid.stl]
2026-10-22 gdoor-din: every part gets a 0.5 mm designator, J4 fitted
    Designators shrink from 0.8/0.12 to 0.5/0.1 mm and all 190 are shown,
    each placed next to its part clear of pads, other silkscreen and the
    other parts' bodies. The DRU and project text-height minimums follow.
    The MPN fields that printed on R1, R3, R4 and R20 are hidden.
    The screw terminals get labels: J4 "-", "+" and "5V" under its pins,
    J1 "~" on both sides and "BUS" (the MB10S bridge makes it polarity-free).
    J4 is no longer DNP or excluded from the BOM, in schematic and board.
    It joins J1 in jlcfab.py's HAND_SOLDERED, so the JLC BOM and CPL are
    unchanged.
    [esp32.kicad_pcb, esp32.kicad_sch]
2026-10-22 gdoor-din enclosure: mirror it so the real board fits
    board_export.py maps KiCad into the enclosure frame with X = 52.4 - (kx -
    100), Y = 87.5 - (ky - 60) and the component side at +Z. That is a
    reflection, so enclosure.scad was laid out around a mirror image of the
    board: the real board would have had its terminals at the wrong edge and
    its RJ45, USB-C and LEDs off their openings.
    Every output now goes through real(), a mirror about z = W/2. The model
    itself is unchanged, the fit check still covers it (mirroring housing and
    ghost together keeps their overlap) and is empty, and the lid is now the
    Z = 0 side, on the right seen from the front window. Engraved labels are
    drawn pre-mirrored so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
    [board_ghost.scad, enclosure.scad, gdoor-din-base.step, gdoor-din-base.stl, gdoor-din-enclosure.step, gdoor-din-lid.step, gdoor-din-lid.stl]
2026-10-22 gdoor-din: animated 3D showcase and its video
    hardware/boards/din/showcase/ is a three.js page, about 46 s in a loop:
    the board, plugs and lid fly together (a reversed exploded view), the
    device hooks onto a TS35 rail in a distribution board and clicks in, gets
    5 V from a DIN-rail supply, the door bus and Ethernet, and then a doorbell
    press runs along the bus, over the board (bus RX, ESP32-S3, W5500), out
    over Ethernet to Home Assistant and onto a phone notification. It uses the
    real board (KiCad GLB export, meshopt-compressed to 1.2 MB) and the
    enclosure STLs as printed; the rest of the scene is simple stand-ins.
    record.mjs renders it frame by frame in headless Edge at exact times
    (?captur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
2026-10-22 gdoor-din: release workflow for din-* tags
    A din-* tag (e.g. din-1.0) builds the DIN board's ESPHome Ethernet and
    WiFi images and attaches them, with the JLCPCB files, iBOM, hand-soldered
    parts list, board STEP (zipped) and enclosure STEP/STL files, to a draft
    release on the fork. A manual run returns the same files as an artifact.
    The PlatformIO and ESPHome workflows now ignore din-* tags: path filters
    do not apply to tag pushes, so they would otherwise build again.
2026-10-22 README: revamp with version comparison and DIN product line
    Hero with badges and photos, feature cards, the classic adapter and
    DIN-rail lines side by side, a v3.0-to-DIN comparison table with a
    timeline, a DIN board section and an MQTT vs ESPHome comparison.
2026-10-22 gdoor-din: regenerate gerbers with the 0.5 mm designators
    The zip still had the silkscreen from before cec9b6f: overlapping 1 mm
    designators and the R20 MPN text. Regenerated with jlcfab.py from the
    current board. Only F.Silkscreen differs; copper, outline and drills are
    unchanged. BOM, CPL and designators.csv came out identical.
2026-10-22 gdoor-din: full-PCBA BOM/CPL and hand-solder list in the release
    jlcfab.py runs a second pass that keeps the hand-soldered parts in and
    writes bom-full.csv / positions-full.csv for a full PCBA order (Standard
    PCBA; C18 on B.Cu stays hand-soldered). It also writes hand_soldered.csv
    from the board's fields, quantities per board, C18 included.
    J4 gets the same rotation override as J1: same terminal, same angle, but
    its offset field put it 180 deg from J1 in the full CPL.
    The DIN release attaches both sets and its notes put the recommended,
    cheaper option first: Economic PCBA, six Extended loading fees saved, no
    through-hole assembly.
    [bom-full.csv, hand_soldered.csv, positions-full.csv]
2026-10-22 gdoor-din: iBOM and board STEP from the current board
    ibom.html regenerated with the InteractiveHtmlBom plugin, same settings
    as before (tracks, nets, Value/Footprint/LCSC fields); it now has R123
    and the 17:14 board. PowerModule.step (3D model of the whole board, for
    the release) exported with the settings in CLAUDE.md. Also adds the
    earlier LCSC hand-solder order list; hand_soldered.csv, generated by
    jlcfab.py, supersedes it (it lacks J4, quantities are for two boards).
    [PowerModule.step, lcsc_hand_soldered.csv]
2026-10-22 Project notes: STEP export settings and the ESPHome voice plan
    CLAUDE.md records how PowerModule.step is exported; esphome/VOICE_PLAN.md
    is the implementation plan for ESPHome and two-way voice on the DIN board.
2026-10-22 ESPHome voice: ES8374 register notes and MONOOUT gain
    Phase 0 step 1 of esphome/VOICE_PLAN.md. The public ES8374 datasheet has
    no register map; the bits come from Espressif's esp_codec_dev driver and
    Everest's Linux ALSA drivers.
    - Register 0x21 bits 5:4 = 01 (the driver's fixed setting) selects
    MIC1P/MIC1N, which carries the bus on the DIN board (C29/R38), so no
    input change is needed. 11 (LIN1-LIN2) would cancel the bus.
    - MONOOUT gain is register 0x1B (bits 3:0, 1.5 dB steps); new substitution
    monoout_gain, default 0x19 = the driver's 13.5 dB, written in
    codec_board_setup after the speaker-off writes.
    - README: register table and how the bus reaches the codec inputs.
    Not tested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
2026-10-22 gdoor-din: J102 to HanRun HY911105AE (C69427)
    HR911105A (C12074) is out of stock at LCSC. HY911105AE is HanRun's
    -40..+85 C version of the same jack: same pinout, LEDs, magnetics and
    hole pattern, so the footprint stays. Updates the LCSC field, value and
    datasheet, and the BOM, hand-solder and price files.
    [bom-full.csv, bom-partdb.csv, esp32.kicad_pcb, hand_soldered.csv, lcsc_hand_soldered.csv, mcu_eth.kicad_sch]
2026-10-22 gdoor-din enclosure: thicker plug clip fingers
    The 1.0 mm fingers flexed enough that the plug gave when the cable plug
    was pressed on. They are now 1.5 mm (about 3.4x as stiff, ~2.8 % strain,
    PETG only). The barrel frame and its slot in the base widen with them, so
    the side walls end on the frame instead of against the base wall.
    [enclosure.scad, gdoor-din-base.step, gdoor-din-base.stl, gdoor-din-enclosure.step, gdoor-din-lid.step, gdoor-din-lid.stl]
2026-10-22 gdoor-din enclosure: 2 mm plug clip fingers
    The clip fingers go from 1.5 to 2.0 mm (8x the original 1.0 mm stiffness,
    about 3.8 % strain while a plug goes in, PETG only). The barrel frame and
    its base slot keep the 1.5 mm width: a wider slot for the 5 V plug would
    reach the front wall. The side walls narrow to the frame over their last
    0.2 mm instead.
    [enclosure.scad, gdoor-din-base.step, gdoor-din-base.stl, gdoor-din-enclosure.step, gdoor-din-lid.step, gdoor-din-lid.stl]
2026-10-23 gdoor-din enclosure: stronger lid snap fingers
    The lid snaps bend across the print layers and broke off at the root
    (about 3.2 % strain). Now 14 mm long, tapered 1.6 to 1.0 mm, with a
    1.0 mm hook and a 0.8 mm root chamfer on the tension side plus a
    matching relief in the base wall: about 0.9 % strain. README notes on
    printing in PLA.
    [enclosure.scad, gdoor-din-base.step, gdoor-din-base.stl, gdoor-din-enclosure.step, gdoor-din-lid.step, gdoor-din-lid.stl]
2026-10-23 gdoor-din enclosure: plug clip fingers rooted behind the hook
    The clip fingers were rooted in front of their hooks, so the cable plug
    pushing the plug back pulled them and the hook offset bent them open;
    only stiffness held the plug (1.0 mm gave, 2.0 mm needed about 4 %
    strain to fit, too much for PLA). Now the finger runs back from the hook
    to a root 11 mm behind it: the same push compresses it and bends the
    hook further in. Tapered 1.4 to 0.8 mm, about 1.2 % strain, fine for
    PLA. A fixed 2 mm side wall stays between frame and hook. The 5 V
    fingers' back part steps up over the RJ45.
    [enclosure.scad, gdoor-din-enclosure.step, gdoor-din-lid.step, gdoor-din-lid.stl]
2026-10-23 gdoor-din enclosure: 3.81 mm plug models in the assembly STEP
    plug_model.py models the 2-pole 3.81 mm pluggable terminal pair from
    photos of the real parts: the 17 mm female in the lid cradle (screw
    section, socket shroud with two pins, no side flanges) and the 15 mm
    cable plug (split tongue with latch nibs). Both have screws, box clamps,
    wire entries and test slots. It writes female, male and mated STEPs.
    step_export.py puts the mated pair at both cradles, the female's mouth
    flush with the outer wall, and writes gdoor-din-enclosure.step with part
    names and colours. The plugs do not overlap the base or the lid.
    [gdoor-din-enclosure.step, plug-3.81-2p-female.step, plug-3.81-2p-male.step, plug-3.81-2p-mated.step]
2026-10-23 gdoor-din enclosure: flush RST/BOOT buttons, full assembly STEP
    RST and BOOT are print-in-place buttons in the lid instead of pin holes
    over tubes. Each is a tongue cut free by a 0.6 mm U-slot, 5.5 mm wide,
    8.5 mm from its root (towards the front) to the pad, thinned to 1.0 mm
    from the inside so its outer face stays flush. Nothing stands proud of
    the lid, so the neighbouring module on the rail cannot press it. A
    3.6 mm plunger stops 0.3 mm above the TL3342 actuator (1.54 mm, from
    its 3D model); full travel is about 0.55 mm at about 1.1 % strain. The
    tongue tilts as it bends, so pad and plunger sit 1.9 mm behind the
    switch centre (btn_off) to centre the tip on the actuator mid-travel.
    Fit che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
    [PowerModule.step, enclosure.scad, gdoor-din-base.step, gdoor-din-base.stl, gdoor-din-enclosure.step, gdoor-din-full.step, gdoor-din-lid.step, gdoor-din-lid.stl]
2026-10-23 gdoor-din enclosure: plug clips forward and closer to the lid plate
    First print: the hooks sat about 1.8 mm behind the plug's back face and
    did not touch it until it was pushed back, and the plug's back end could
    drop towards the lid plate and slip under them.
    - plug_back 17 -> 15.2: the female's mouth stands about 1.8 mm proud.
    Hooks 1.6 mm further forward, 0.3 mm play to the back face.
    - clip_free 11 -> 9.5, so the 45 deg cut lets the hook come 1.5 mm closer
    to the lid plate: it now covers 5.5 to 10.5 mm above the plug's flat
    side (was 7 to 10.5). Root 1.4 -> 1.2 mm: about 1.5 % strain.
    - Platform under the whole plug, back to the fingers' anchors, 0.6 mm
    clear of them.
    - step_exp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
    [enclosure.scad, gdoor-din-enclosure.step, gdoor-din-full.step, gdoor-din-lid.step, gdoor-din-lid.stl]
2026-10-23 gdoor-din enclosure: plug back at 17 mm again
    ee8c0bc moved the plug itself (plug_back 17 -> 15.2) and with it the
    plugs and wires in step_export.py and full_assembly.py. That was wrong:
    the plug position was correct. Restores plug_back, the hooks' 0.1 mm
    play and the three scripts. Keeps the platform under the whole plug and
    the hook 1.5 mm closer to the lid plate.
    [enclosure.scad, gdoor-din-enclosure.step, gdoor-din-full.step, gdoor-din-lid.step, gdoor-din-lid.stl]
2026-10-23 gdoor-din enclosure: plug clip hooks 1.8 mm forward
    On the first print the hooks sat about 1.8 mm too far back and did not
    touch the plug until it was pushed back. clip_fwd moves only the hooks
    (with their fingers and the side walls' back ends) 1.8 mm towards the
    frame. The plug position is unchanged, so the model's hooks now reach
    about 1.6 mm into the modelled plug.
    [enclosure.scad, gdoor-din-enclosure.step, gdoor-din-full.step, gdoor-din-lid.step, gdoor-din-lid.stl]
2026-10-23 gdoor-din enclosure: platform back to 8.05 mm
    The full-length platform under the plug (ee8c0bc) stops the L-shaped
    plug from being fitted. Back to the original 8.05 mm from the outer
    face; 9 mm is the limit.
    [enclosure.scad, gdoor-din-lid.step, gdoor-din-lid.stl]
2026-10-23 gdoor-din enclosure: plug screws and wire entries on the shroud side
    On the real parts the screw face, with the wire entries next to it, is
    flush with the female's socket shroud and the male's tongue. plug_model.py
    had both screw sections on the opposite side; it now builds them turned
    over. Shroud, tongue, pins and the plug's place in the cradle are
    full_assembly.py takes the wire-entry height from plug_model instead of a
    fixed value, so the mock wires follow the entries. Regenerated the plug
    STEPs, gdoor-din-enclosure.step and gdoor-din-full.step; the wires overlap
    nothing.
    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
    [gdoor-din-enclosure.step, gdoor-din-full.step, plug-3.81-2p-female.step, plug-3.81-2p-male.step, plug-3.81-2p-mated.step]
2026-10-24 gdoor-din enclosure: colour accents for a multi-material print
    New parts base_body / base_accent / lid_body / lid_accent split each part
    into two colours; together they are the single-colour part with its
    engraved labels filled flush. Accent: a 0.8 mm fascia on the front window
    face (LAN, USB and GDoor left in the body colour), the lid's window nose,
    the RST/BOOT pads and labels (0.4 mm, first two layers), and the 5V/BUS
    labels (0.8 mm, upright in the print). part="colours" previews them.
    The single-colour base and lid, and the fit check, are unchanged.
    [enclosure.scad, gdoor-din-base-accent.stl, gdoor-din-base-body.stl, gdoor-din-lid-accent.stl, gdoor-din-lid-body.stl]
2026-10-24 gdoor-din enclosure: unsliced 3MF of the base and lid
    gdoor-din-base.3mf and gdoor-din-lid.3mf next to the STLs, exported by
    OpenSCAD from the same parts: mesh only, in mm, print orientation, no
    print settings. Same extents and volume as the STLs. README build steps
    and the project CLAUDE.md now say to rebuild them with the STLs.
    [gdoor-din-base.3mf, gdoor-din-lid.3mf]
2026-10-24 gdoor-din enclosure: two-colour 3MF of the base and lid
    colour_3mf.py packs each part's body and accent STLs into one 3MF: one
    object made of two components, named body and accent. Bambu Studio
    loads it as one object with two parts (checked by re-saving it through
    its CLI); since it ignores the component names, the file carries its
    model_settings.config with the names only. No extruder, filament,
    printer or process settings.
    [gdoor-din-base-colour.3mf, gdoor-din-lid-colour.3mf]
2026-10-24 gdoor-din enclosure: base and lid in one colour 3MF
    gdoor-din-colour.3mf replaces gdoor-din-base-colour.3mf and
    gdoor-din-lid-colour.3mf: both parts in one file, side by side on the
    plate (moved, not turned), each one object with body and accent parts.
    Bambu Studio's CLI loads it as two objects on one plate with the parts
    named. Still no print settings.
    [gdoor-din-base-colour.3mf, gdoor-din-colour.3mf, gdoor-din-lid-colour.3mf]
2026-10-24 gdoor-din enclosure: one single-colour 3MF, 3MFs in the DIN release
    gdoor-din.3mf replaces gdoor-din-base.3mf and gdoor-din-lid.3mf: base and
    lid side by side in one unsliced file, geometry only. print_3mf.py
    (was colour_3mf.py) writes it and gdoor-din-colour.3mf, which comes out
    unchanged. Bambu Studio's CLI loads it as two objects on one plate.
    din-release.yml now attaches both as <N>-enclosure.3mf and
    <N>-enclosure-colour.3mf, and the release notes say which to open.
    [gdoor-din-base.3mf, gdoor-din-lid.3mf, gdoor-din.3mf]
2026-10-24 gdoor-din enclosure: one Bambu 3MF with two plates
    gdoor-din.3mf now holds both versions on two Bambu Studio plates: plate 1
    the single-colour base and lid, plate 2 both with body and accent parts
    (accent on filament 2). gdoor-din-colour.3mf is gone; the DIN release
    attaches the one file.
    Plates exist only in Bambu's project format, and Bambu Studio crashes on
    a project without Metadata/project_settings.config (checked with a file
    it saved itself). So the file carries bambu_project_settings.config, the
    P1S 0.2 nozzle / 0.10mm Standard @BBL X1C 0.2 nozzle / PLA Basic x2,
    written by Bambu Studio from its system profiles with the inherits chains
    resolved (its CLI does not resolve them and fall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
    [gdoor-din-colour.3mf, gdoor-din.3mf]
2026-10-24 gdoor-din enclosure: printed keepers hold the plugs instead of clip fingers
    The spring clip fingers on the lid cradles never held the plugs reliably.
    Each plug is now held by a separate printed U-shaped keeper that drops into
    grooves in the cradle's side walls behind the plug's back face, legs beside
    the wire entries and wires out between them. The push of the cable plug
    goes straight into the groove walls; nothing has to bend.
    New gdoor-din-keeper.stl/.step (print two), both 3MF plates carry them,
    the enclosure and full STEPs include them, and the DIN release ships the
    keeper STL and STEP. Fit check and mock-wire check: no new collisions.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
    [enclosure.scad, gdoor-din-enclosure.step, gdoor-din-full.step, gdoor-din-keeper.step, gdoor-din-keeper.stl, gdoor-din-lid-body.stl, gdoor-din-lid.step, gdoor-din-lid.stl]
2026-10-24 gdoor-din enclosure: keeper turned over, open towards the lid plate
    The plug's wire entries are on its lid side (efc6c62), so the keeper's
    bridge sat right where the wires come out. The U now stands on the lid
    plate with its legs, open there for the wires, and the bridge closes it at
    the board end, across the full width of the back face from 5.6 mm off the
    plug's lid-side face. Fit check and mock-wire check: no new collisions.
    [enclosure.scad, gdoor-din-enclosure.step, gdoor-din-full.step, gdoor-din-keeper.step, gdoor-din-keeper.stl, gdoor-din.3mf]
2026-10-24 gdoor-din enclosure: Bambu settings saved in the 3MF survive a rebuild
    Philipp's slicing settings, saved from Bambu Studio into gdoor-din.3mf
    (P1S 0.4 nozzle, 0.20mm Standard @BBL P1S with his changes, PLA Basic x2),
    are now bambu_project_settings.config. print_3mf.py reads the existing
    gdoor-din.3mf before overwriting it and carries over its project settings
    (copied back into bambu_project_settings.config) and every object, part and
    plate setting, matched by name. Rebuilding twice gives the same file, and
    Bambu Studio loads it with his profile.
    [gdoor-din.3mf]
2026-10-24 gdoor-din enclosure: round fillet at the snap fingers' cavity-side root
    The finger roots had a chamfer on the outer side but a sharp corner on the
    cavity side, which goes into tension when the closed lid is pulled with the
    hooks caught. A 1.2 mm round fillet into the lid plate (snap_gus) removes
    it; it prints on the plate with no overhang. Fit check and mock-wire check:
    no new collisions. Lid STLs, 3MF (saved Bambu settings kept) and STEPs
    rebuilt.
    [enclosure.scad, gdoor-din-enclosure.step, gdoor-din-full.step, gdoor-din-lid-body.stl, gdoor-din-lid.step, gdoor-din-lid.stl, gdoor-din.3mf]
