Pytonballoon810/gdoor/(notices)

Notices in the files:
firmware/src/wifi_helper.cpp:
This program is free software: you can redistribute it and/or modify
it under the terms of the GNU General Public License as published by
the Free Software Foundation, version 3.
README.md:
License: GPL-3.0
